EwoudVV/rgb-tiles/images/tile-layout-sketch.png

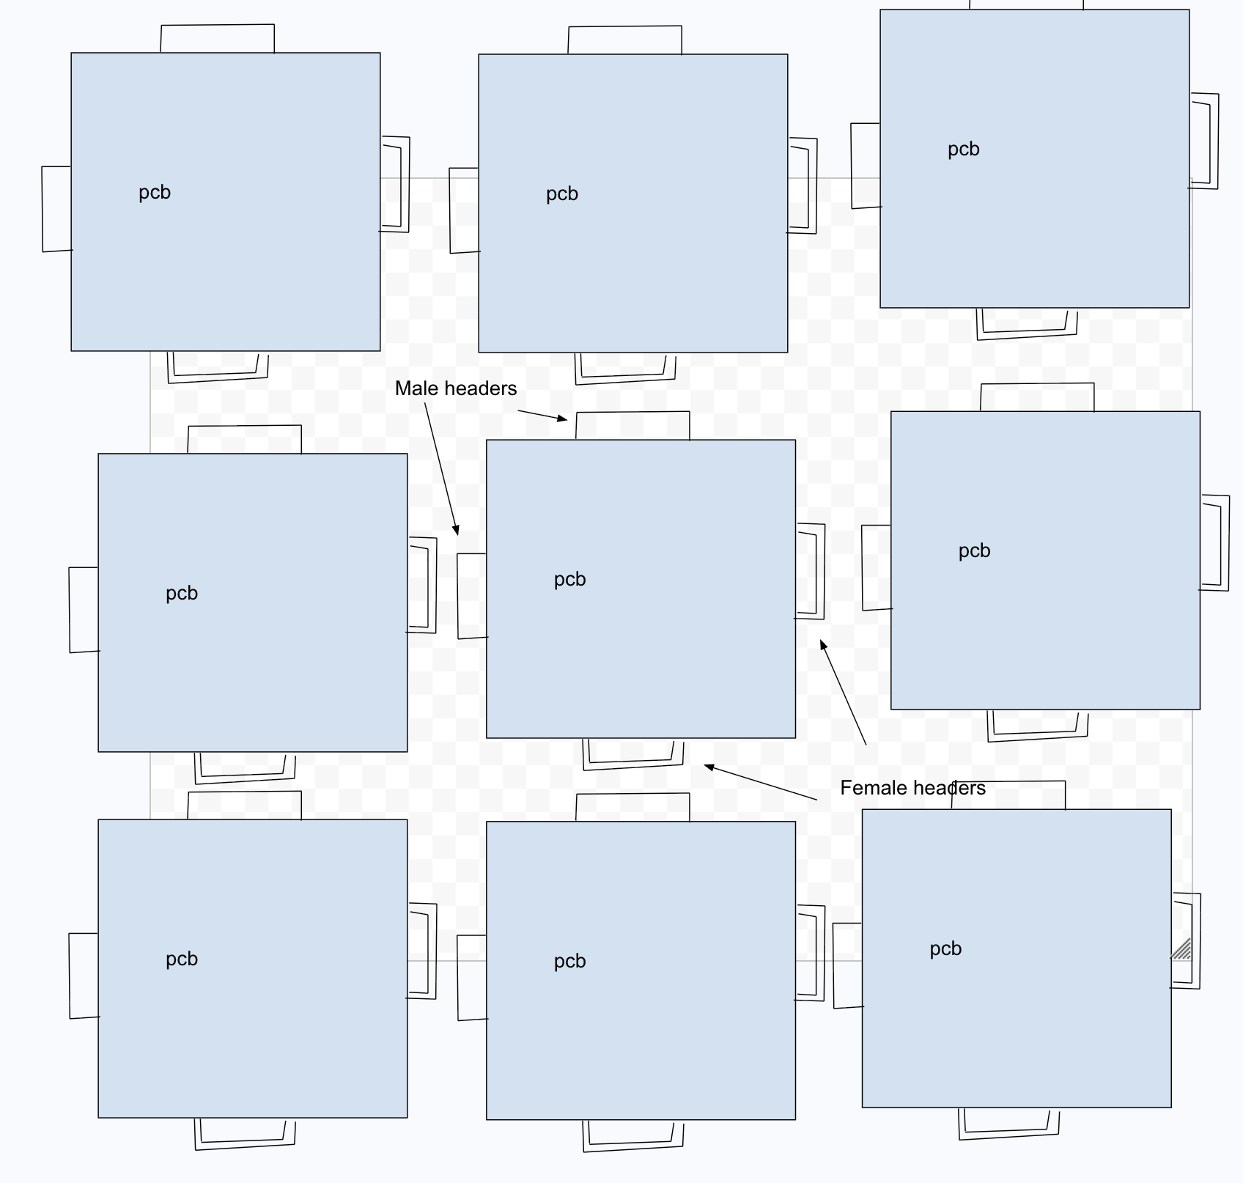
images/tile-layout-sketch.png
