EwoudVV/rgb-tiles/images/tile-render.png

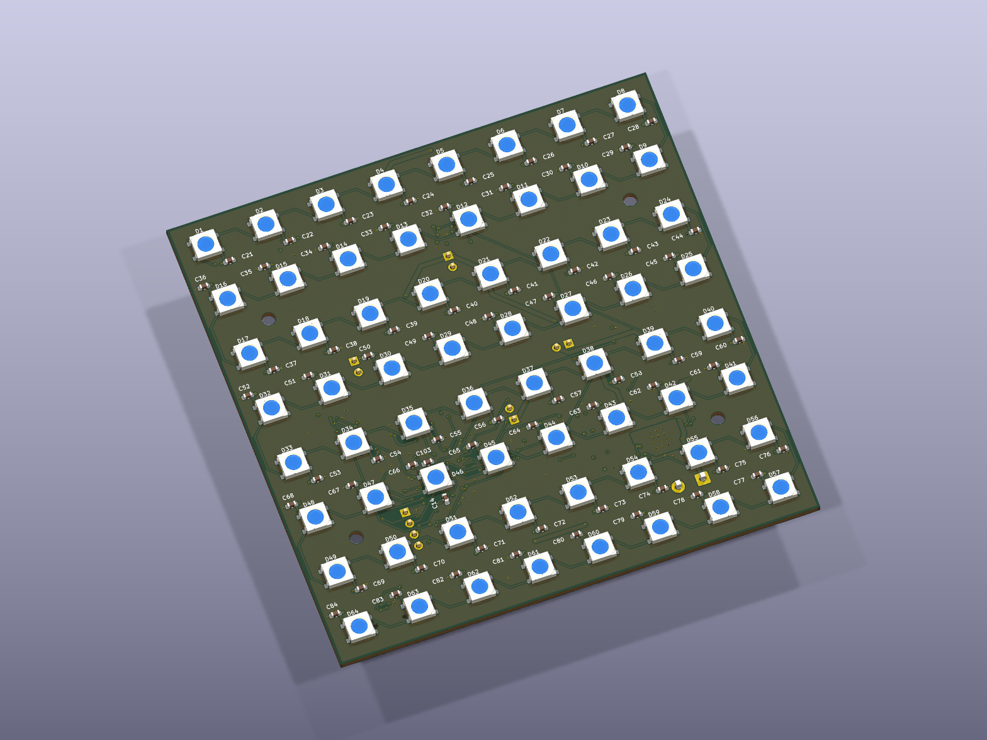
images/tile-render.png
