EwoudVV/rgb-tiles/rgb-tiles.kicad_pcb

## KiCad design rgb-tiles.kicad_pcb (2026-10-29)

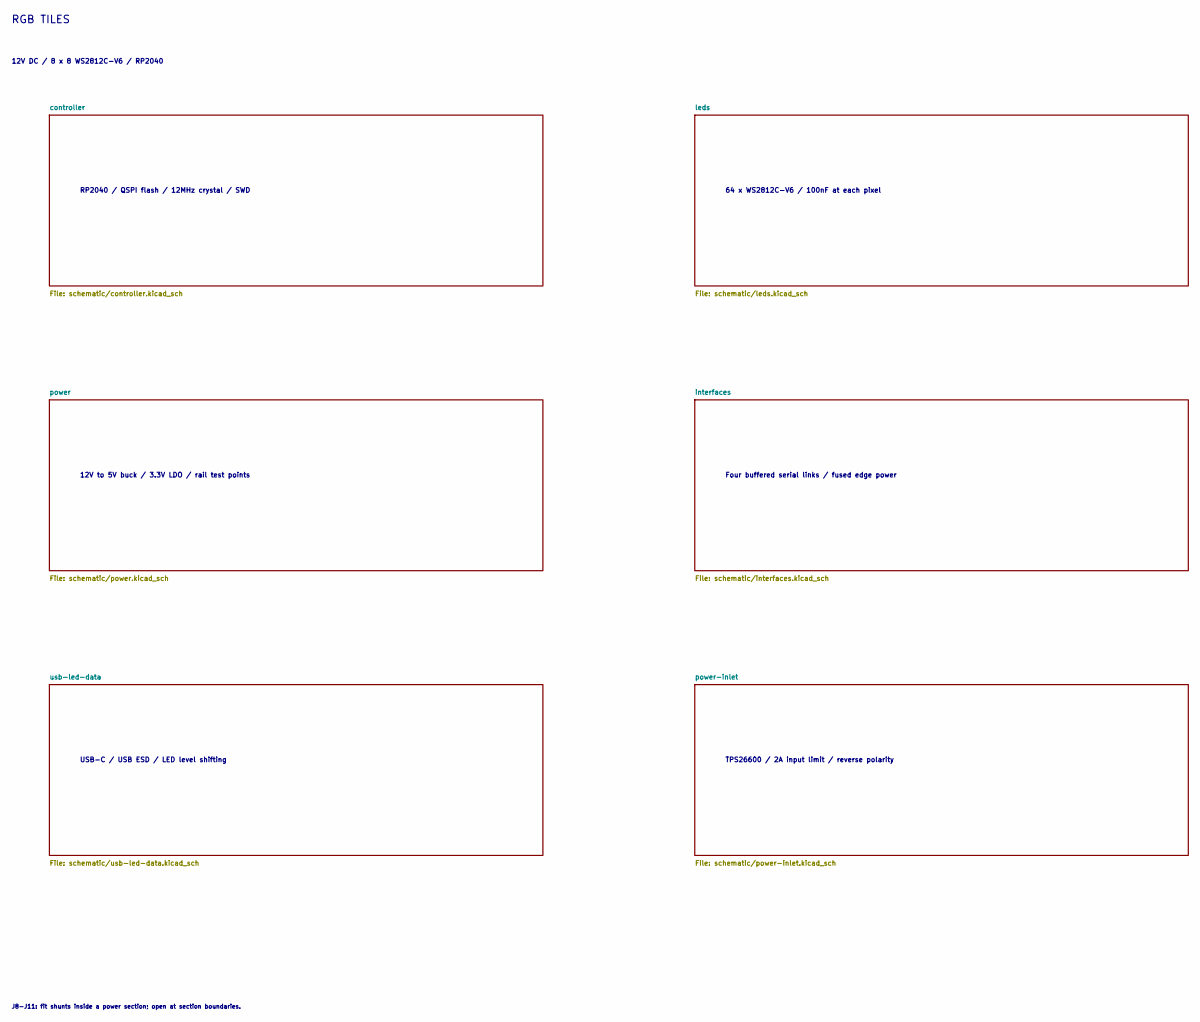
[picture p5: schematic rgb-tiles.kicad_sch, RGB Tiles]

Notes on the sheet:
RGB TILES
12V DC / 8 x 8 WS2812C-V6 / RP2040
J8-J11: fit shunts inside a power section; open at section boundaries.
RP2040 / QSPI flash / 12MHz crystal / SWD
64 x WS2812C-V6 / 100nF at each pixel
12V to 5V buck / 3.3V LDO / rail test points
Four buffered serial links / fused edge power
USB-C / USB ESD / LED level shifting
TPS26600 / 2A input limit / reverse polarity

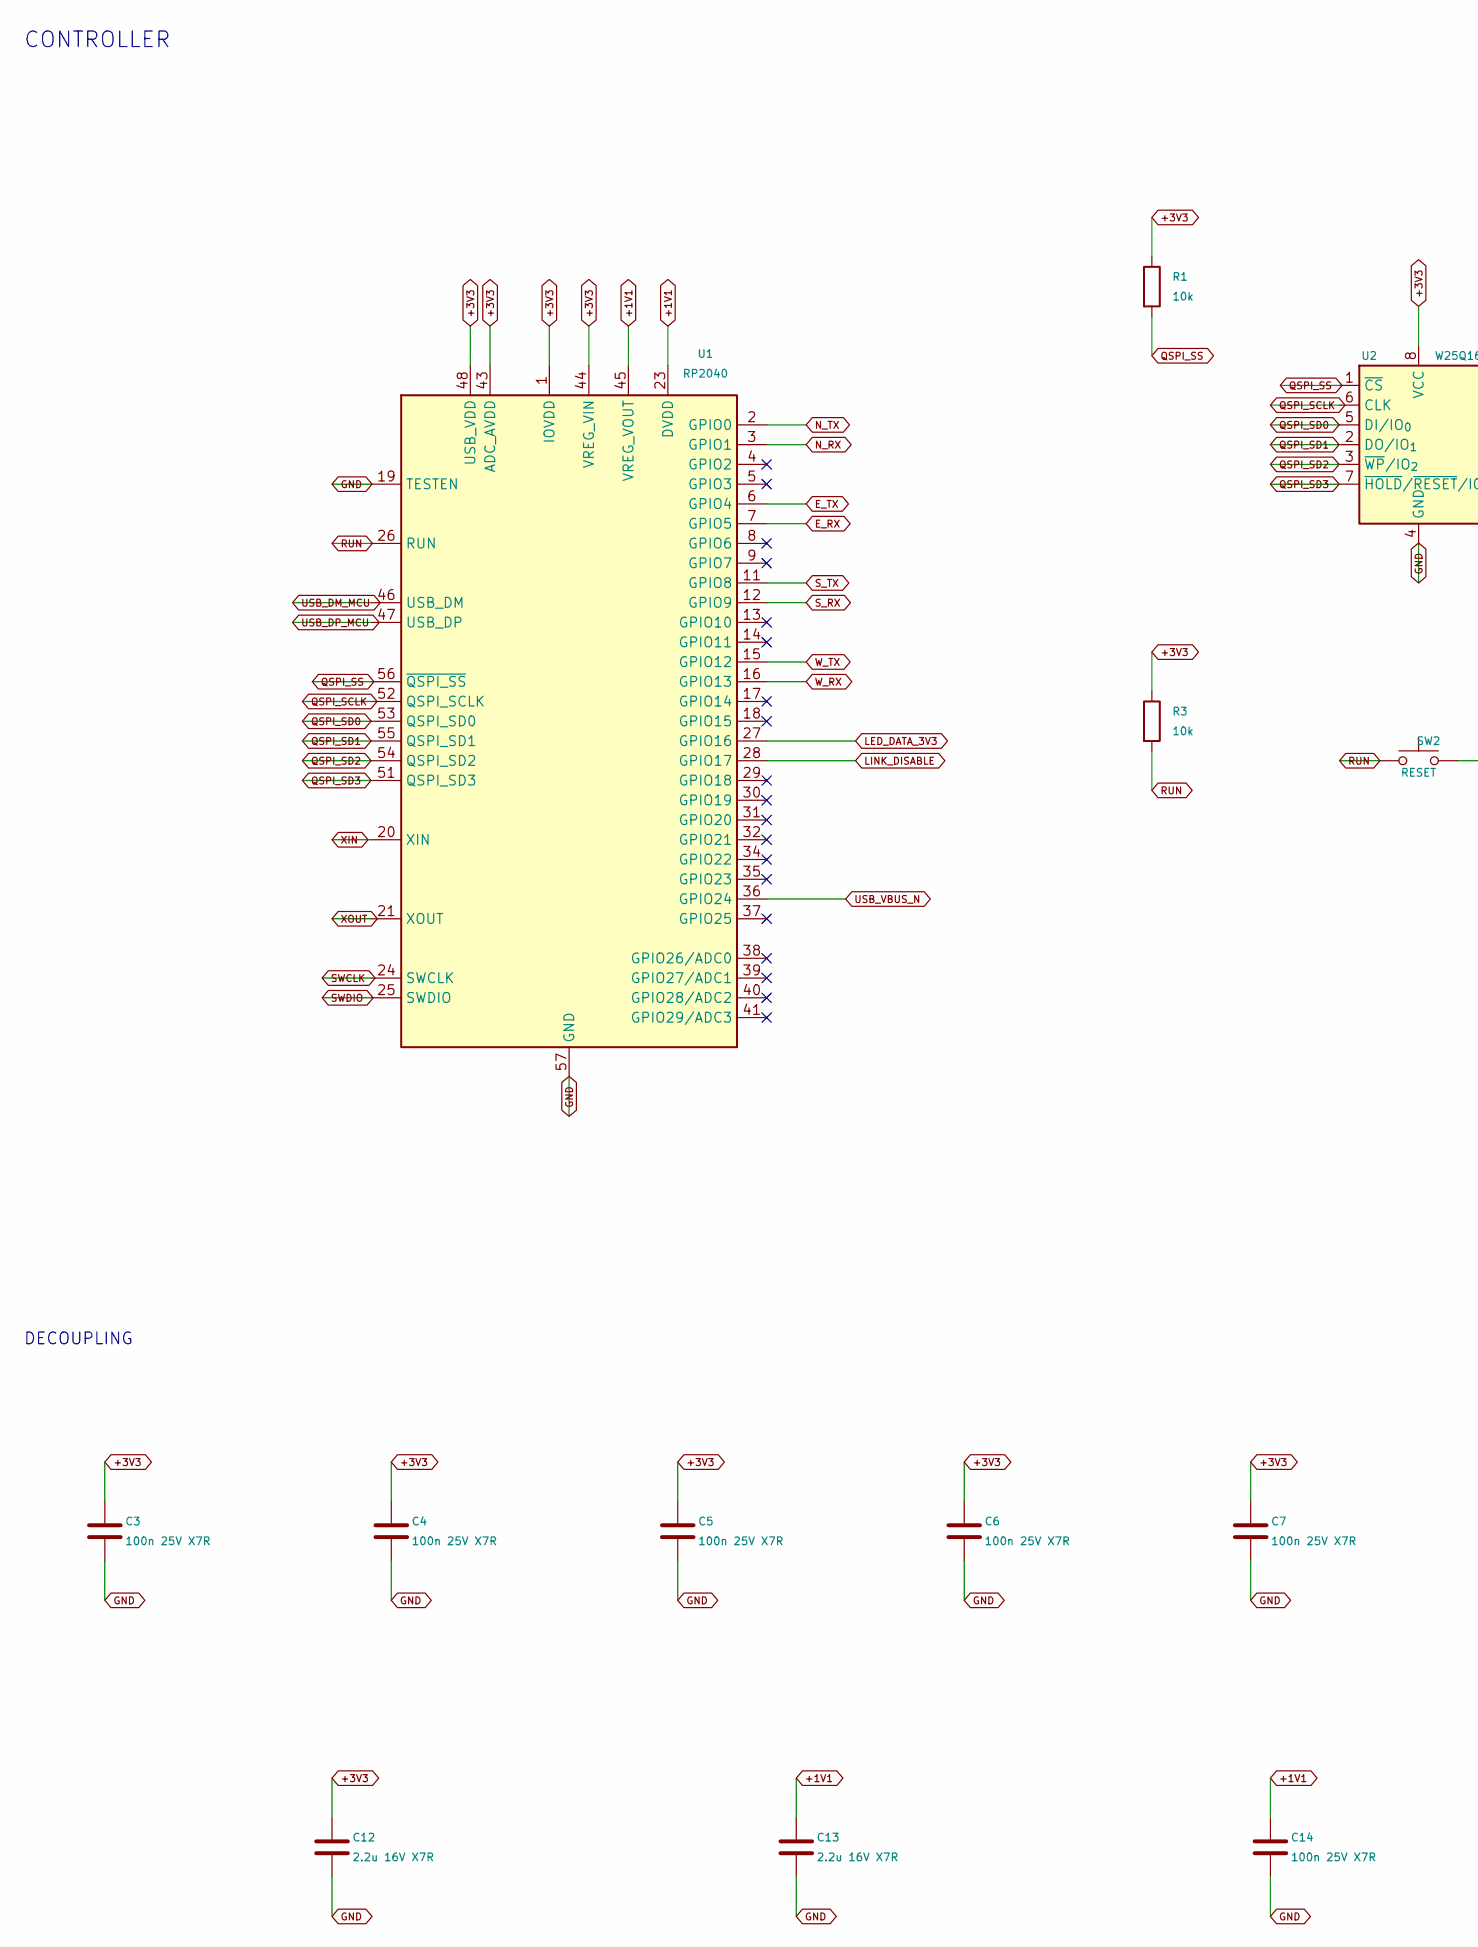
[picture p6: schematic controller.kicad_sch, RGB Tiles, part in row 1, column 1]

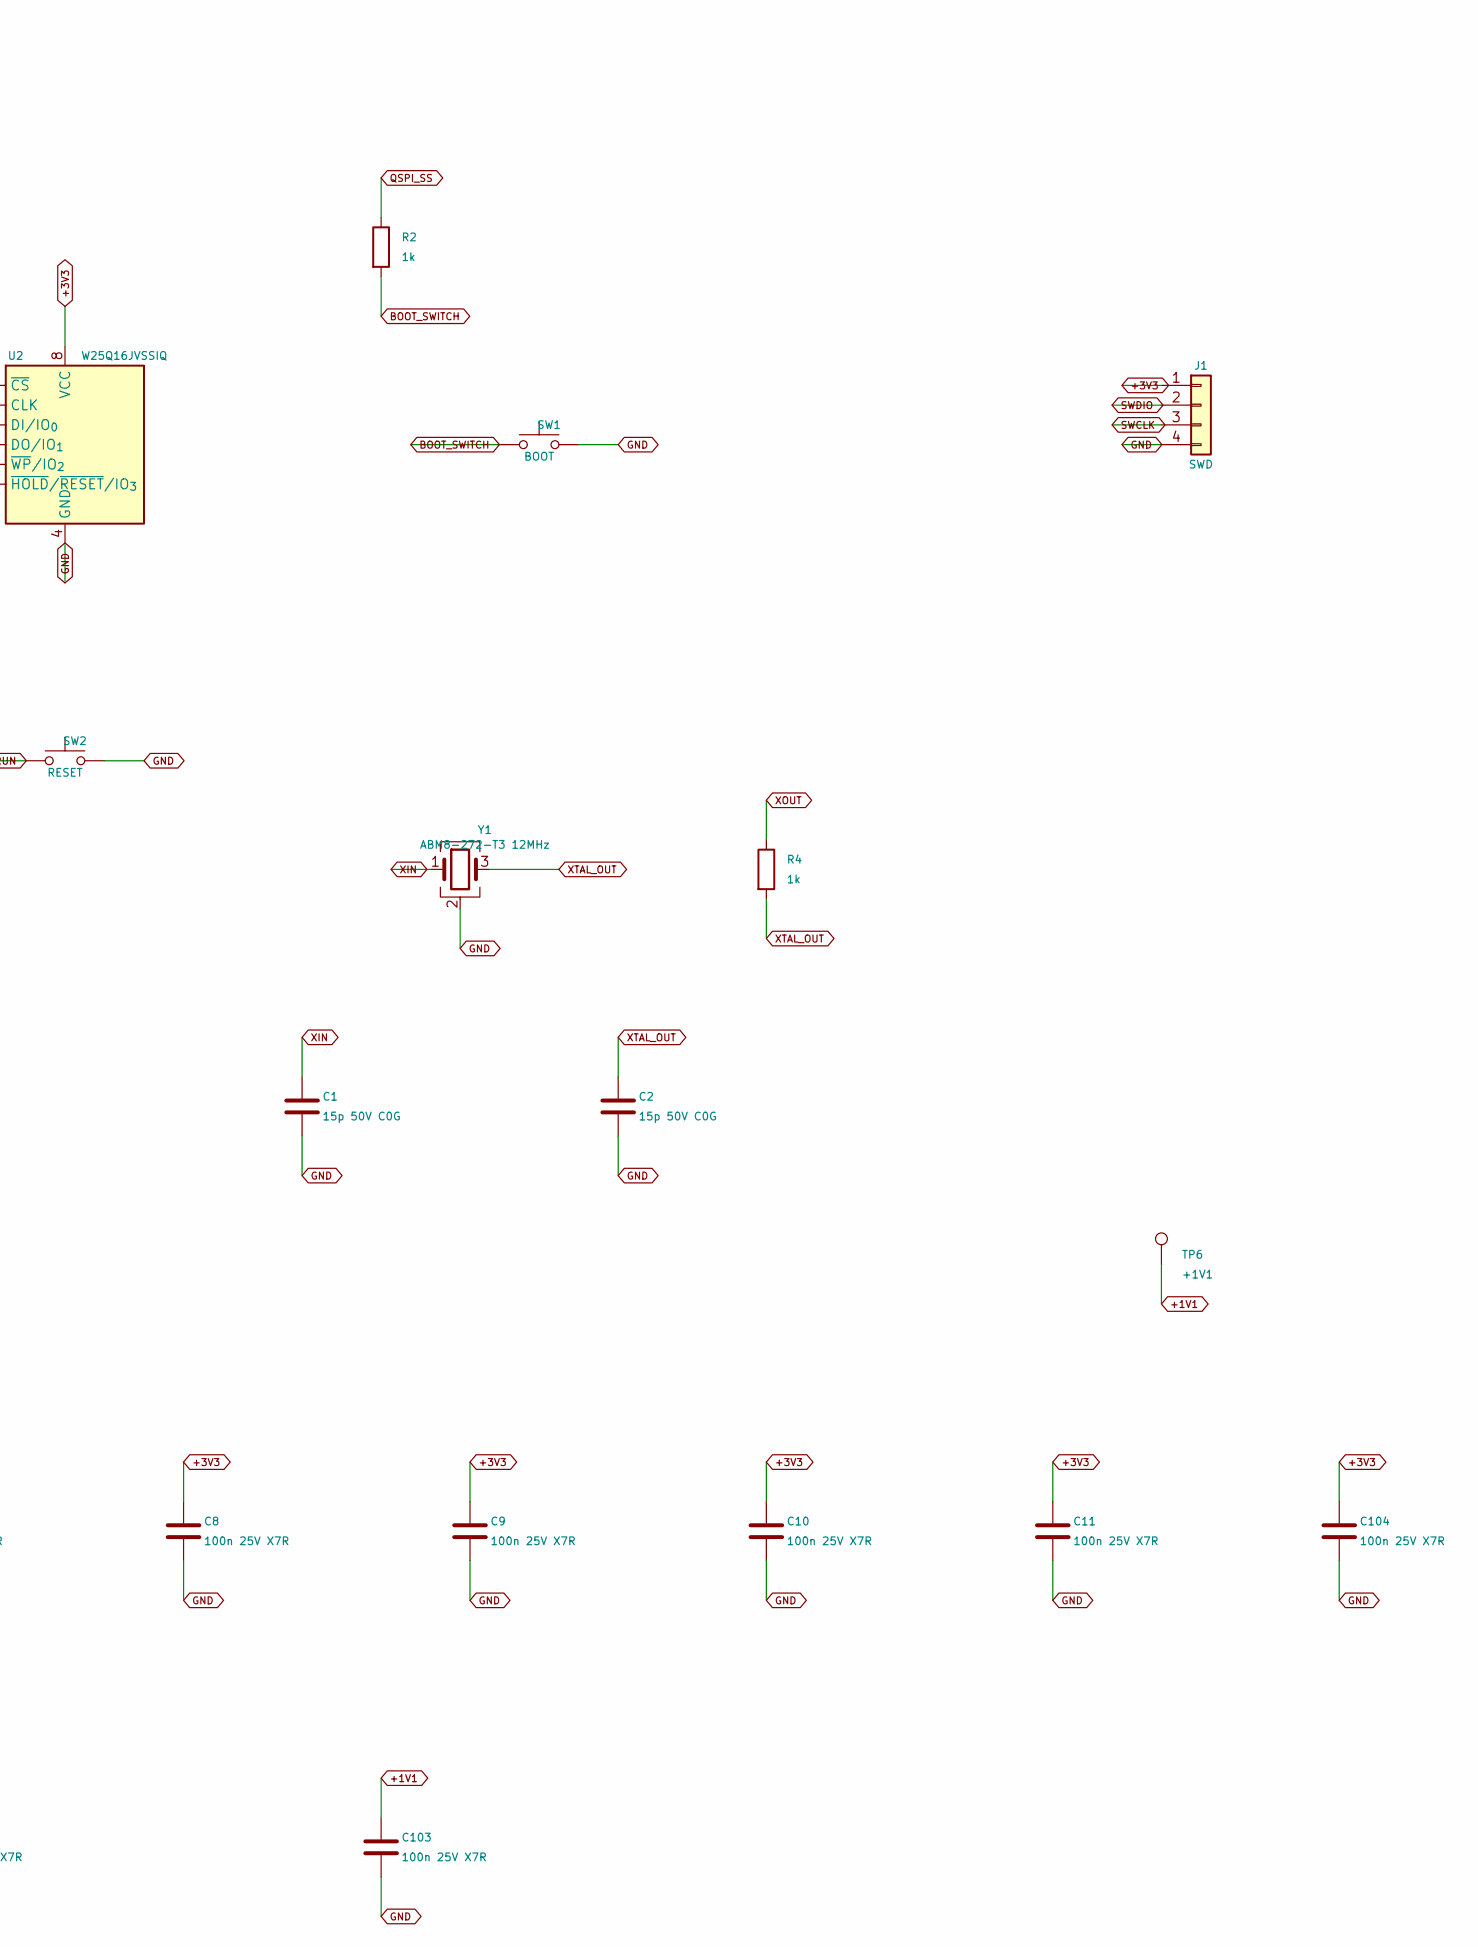
[picture p7: schematic controller.kicad_sch, RGB Tiles, part in row 1, column 2]

Parts:
C1, C2: 15p 50V C0G; C_0603_1608Metric; MPN C0603C150J5GACTU
C3, C4, C5, C6, C7, C8, C9, C10, C11, C14, C103, C104: 100n 25V X7R; C_0603_1608Metric; MPN CL10B104KA8NNNC
C12, C13: 2.2u 16V X7R; C_0805_2012Metric; MPN C0805C225K4RACTU
J1: SWD; PinHeader_1x04_P2.54mm_Vertical; MPN TSW-104-07-T-S
R1, R3: 10k; R_0603_1608Metric; Tolerance 1%; MPN RC0603FR-0710KL
R2, R4: 1k; R_0603_1608Metric; Tolerance 1%; MPN RC0603FR-071KL
SW1: BOOT; SW_SPST_TL3342; MPN TL3342F160QG
SW2: RESET; SW_SPST_TL3342; MPN TL3342F160QG
TP6: +1V1; TestPoint_Pad_D1.5mm
U1: RP2040; QFN-56-1EP_7x7mm_P0.4mm_EP3.2x3.2mm; MPN RP2040
U2: W25Q16JVSSIQ; SOIC-8_5.3x5.3mm_P1.27mm; MPN W25Q16JVSSIM
Y1: ABM8-272-T3 12MHz; Crystal_SMD_3225-4Pin_3.2x2.5mm; MPN ABM8-272-T3

Connections:
+1V1: C13.1, C14.1, C103.1, TP6.1, U1.23 (DVDD), U1.45 (VREG_VOUT), U1.50 (DVDD)
+3V3: C3.1, C4.1, C5.1, C6.1, C7.1, C8.1, C9.1, C10.1, C11.1, C12.1, C104.1, J1.1, R1.1, R3.1, U1.1 (IOVDD), U1.10 (IOVDD), U1.22 (IOVDD), U1.33 (IOVDD), U1.42 (IOVDD), U1.43 (ADC_AVDD), U1.44 (VREG_VIN), U1.48 (USB_VDD), U1.49 (IOVDD), U2.8 (VCC); also elsewhere on the board
BOOT_SWITCH: R2.2, SW1.1
E_RX: U1.7 (GPIO5); also elsewhere on the board
E_TX: U1.6 (GPIO4); also elsewhere on the board
GND: C1.2, C2.2, C3.2, C4.2, C5.2, C6.2, C7.2, C8.2, C9.2, C10.2, C11.2, C12.2, C13.2, C14.2, C103.2, C104.2, J1.4, SW1.2, SW2.2, U1.19 (TESTEN), U1.57 (GND), U2.4 (GND), Y1.2 (G), Y1.4 (G); also elsewhere on the board
LED_DATA_3V3: U1.27 (GPIO16); also elsewhere on the board
LINK_DISABLE: U1.28 (GPIO17); also elsewhere on the board
N_RX: U1.3 (GPIO1); also elsewhere on the board
N_TX: U1.2 (GPIO0); also elsewhere on the board
QSPI_SCLK: U1.52 (QSPI_SCLK), U2.6 (CLK)
QSPI_SD0: U1.53 (QSPI_SD0), U2.5 (DI/IO_{0})
QSPI_SD1: U1.55 (QSPI_SD1), U2.2 (DO/IO_{1})
QSPI_SD2: U1.54 (QSPI_SD2), U2.3 (~WP/IO_{2})
QSPI_SD3: U1.51 (QSPI_SD3), U2.7 (~HOLD/~RESET/IO_{3})
QSPI_SS: R1.2, R2.1, U1.56 (~QSPI_SS), U2.1 (~CS)
RUN: R3.2, SW2.1, U1.26 (RUN)
SWCLK: J1.3, U1.24 (SWCLK)
SWDIO: J1.2, U1.25 (SWDIO)
S_RX: U1.12 (GPIO9); also elsewhere on the board
S_TX: U1.11 (GPIO8); also elsewhere on the board
USB_DM_MCU: U1.46 (USB_DM); also elsewhere on the board
USB_DP_MCU: U1.47 (USB_DP); also elsewhere on the board
USB_VBUS_N: U1.36 (GPIO24); also elsewhere on the board
W_RX: U1.16 (GPIO13); also elsewhere on the board
W_TX: U1.15 (GPIO12); also elsewhere on the board
XIN: C1.1, U1.20 (XIN), Y1.1
XOUT: R4.1, U1.21 (XOUT)
XTAL_OUT: C2.1, R4.2, Y1.3

Notes on the sheet:
CONTROLLER
DECOUPLING
