EwoudVV/rgb-tiles/rgb-tiles.kicad_pcb

## KiCad design rgb-tiles.kicad_pcb (continued)

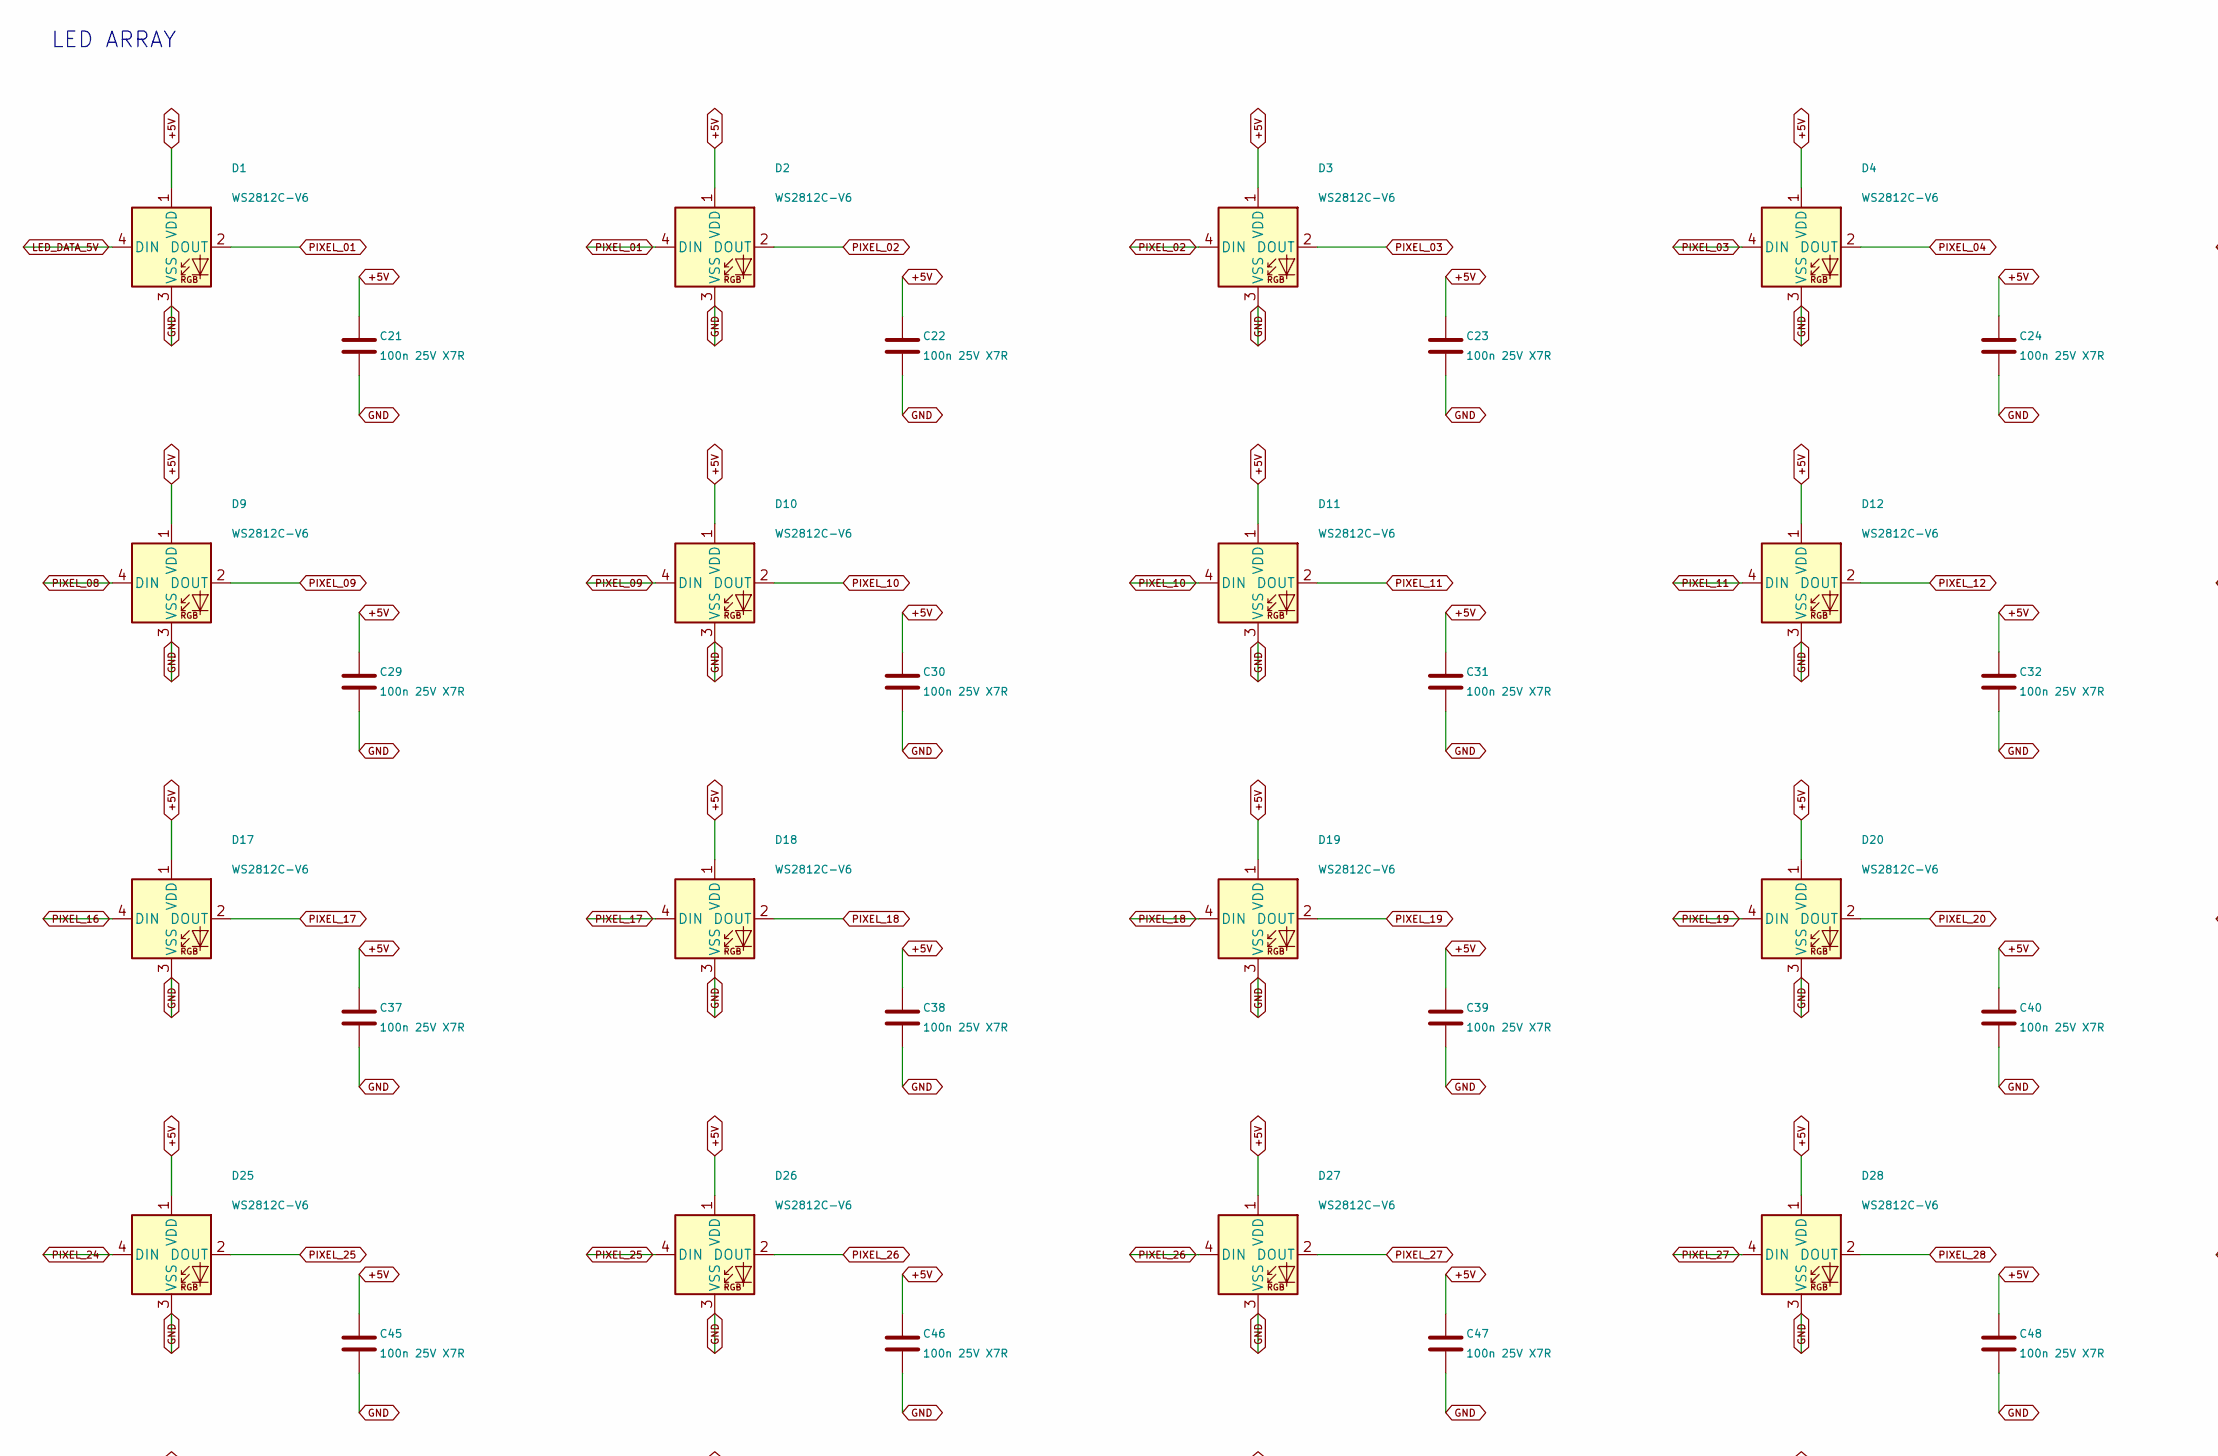
[picture p8: schematic leds.kicad_sch, RGB Tiles, part in row 1, column 1]

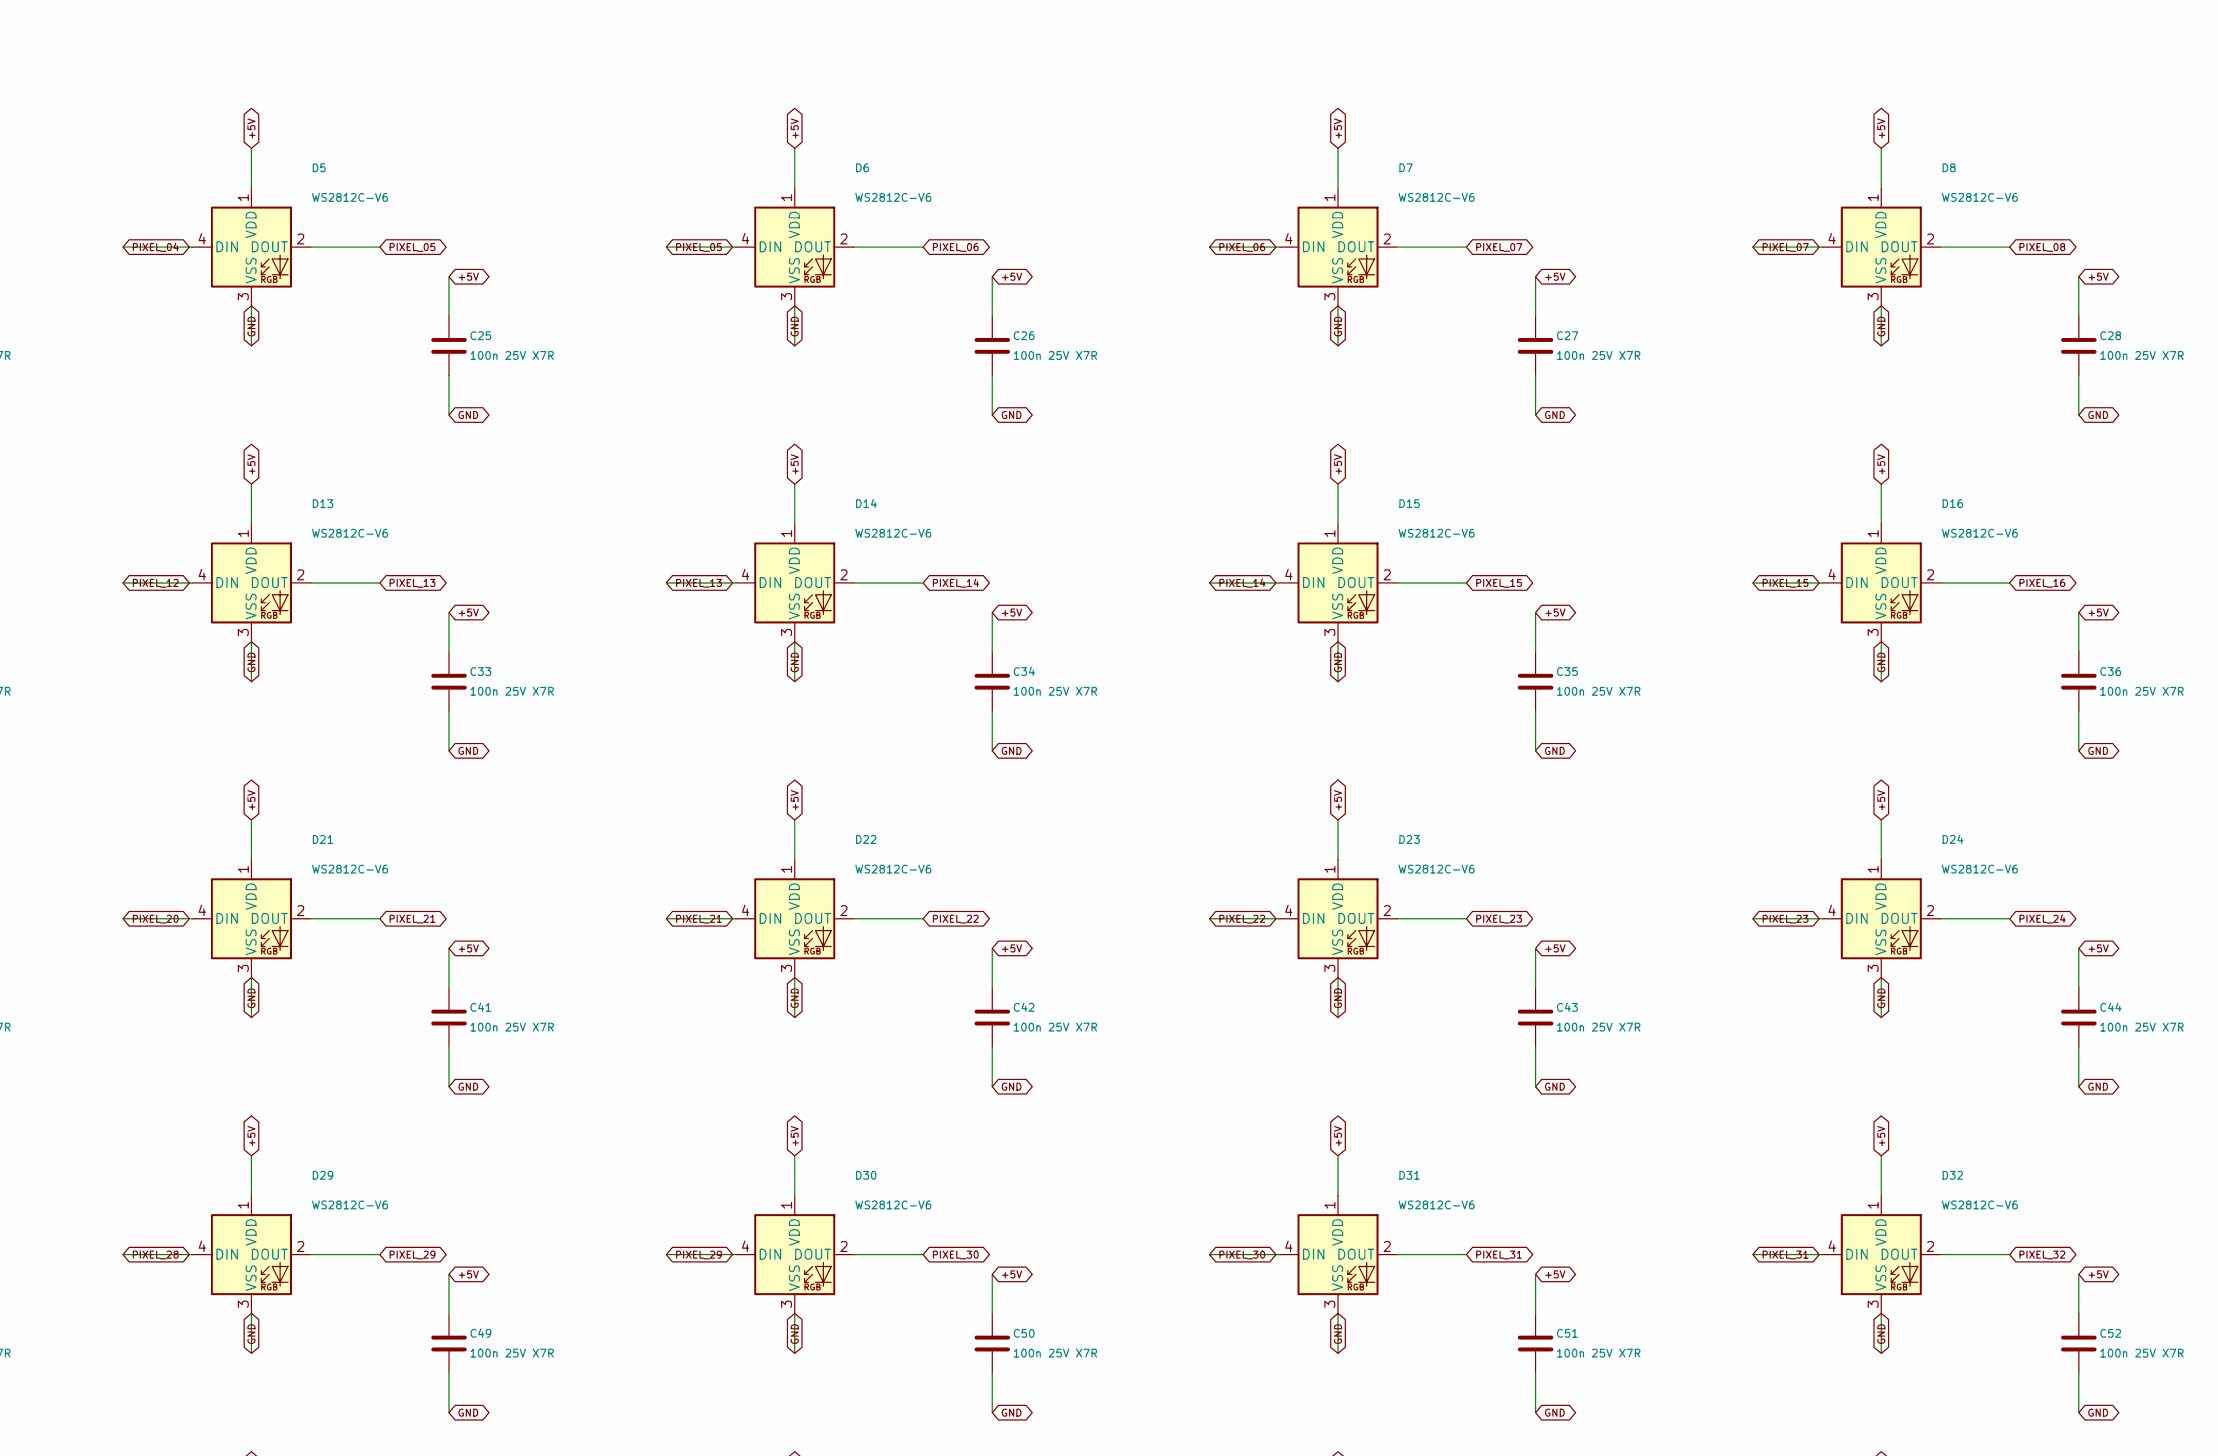
[picture p9: schematic leds.kicad_sch, RGB Tiles, part in row 1, column 2]

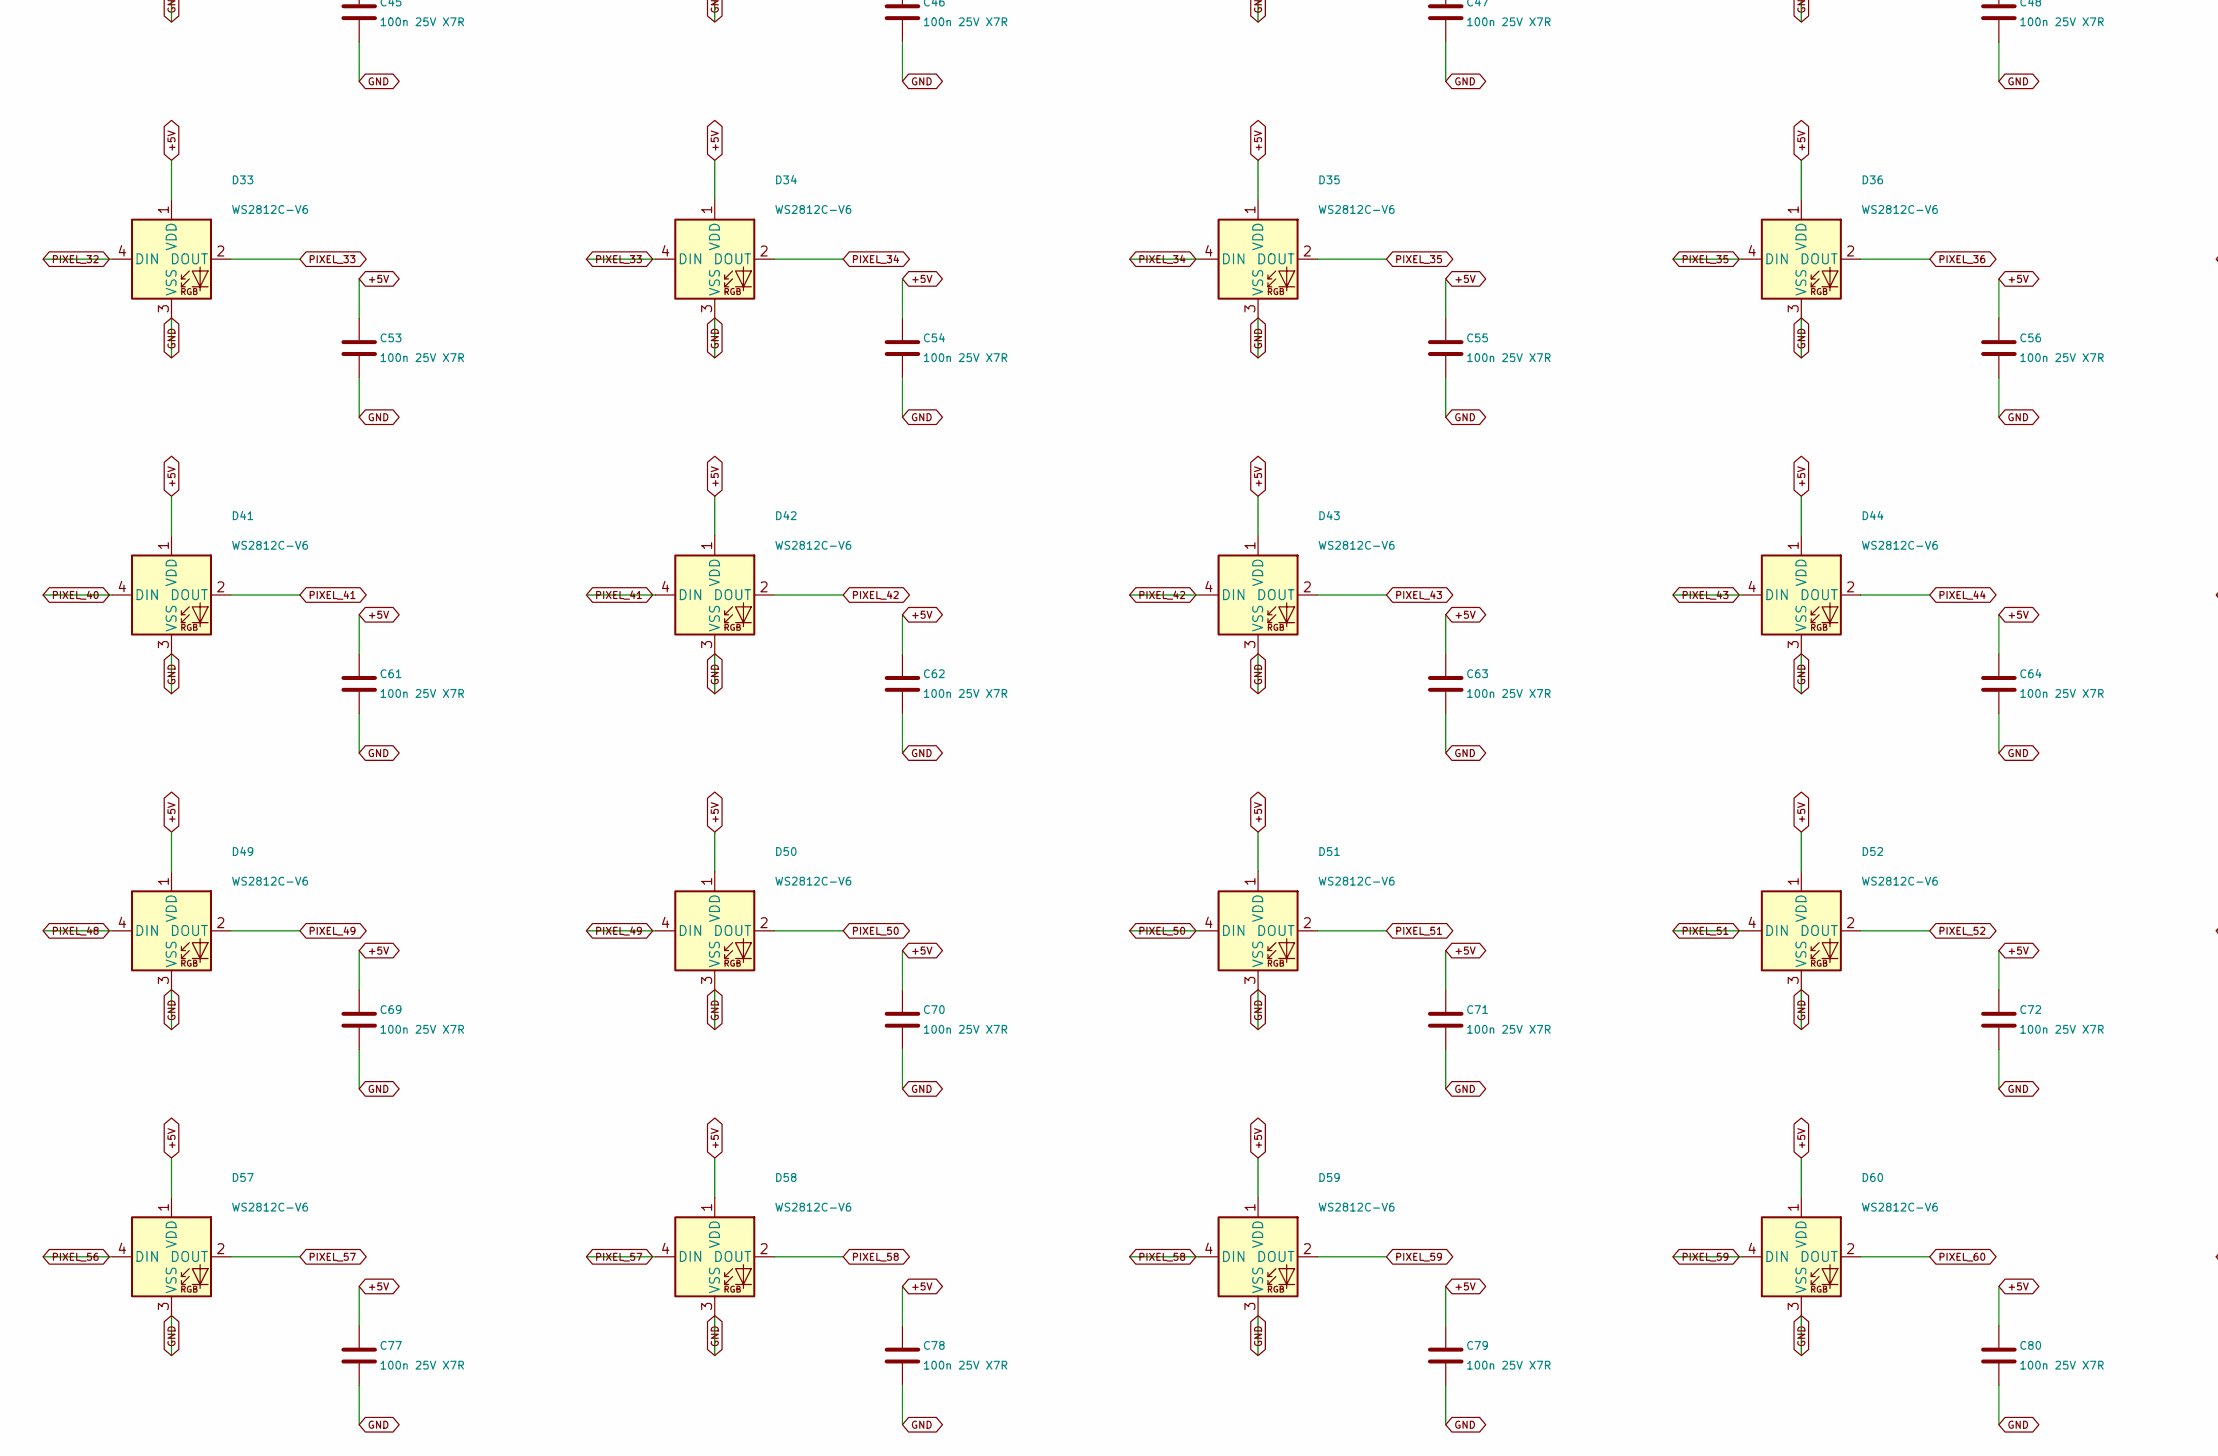
[picture p10: schematic leds.kicad_sch, RGB Tiles, part in row 2, column 1]

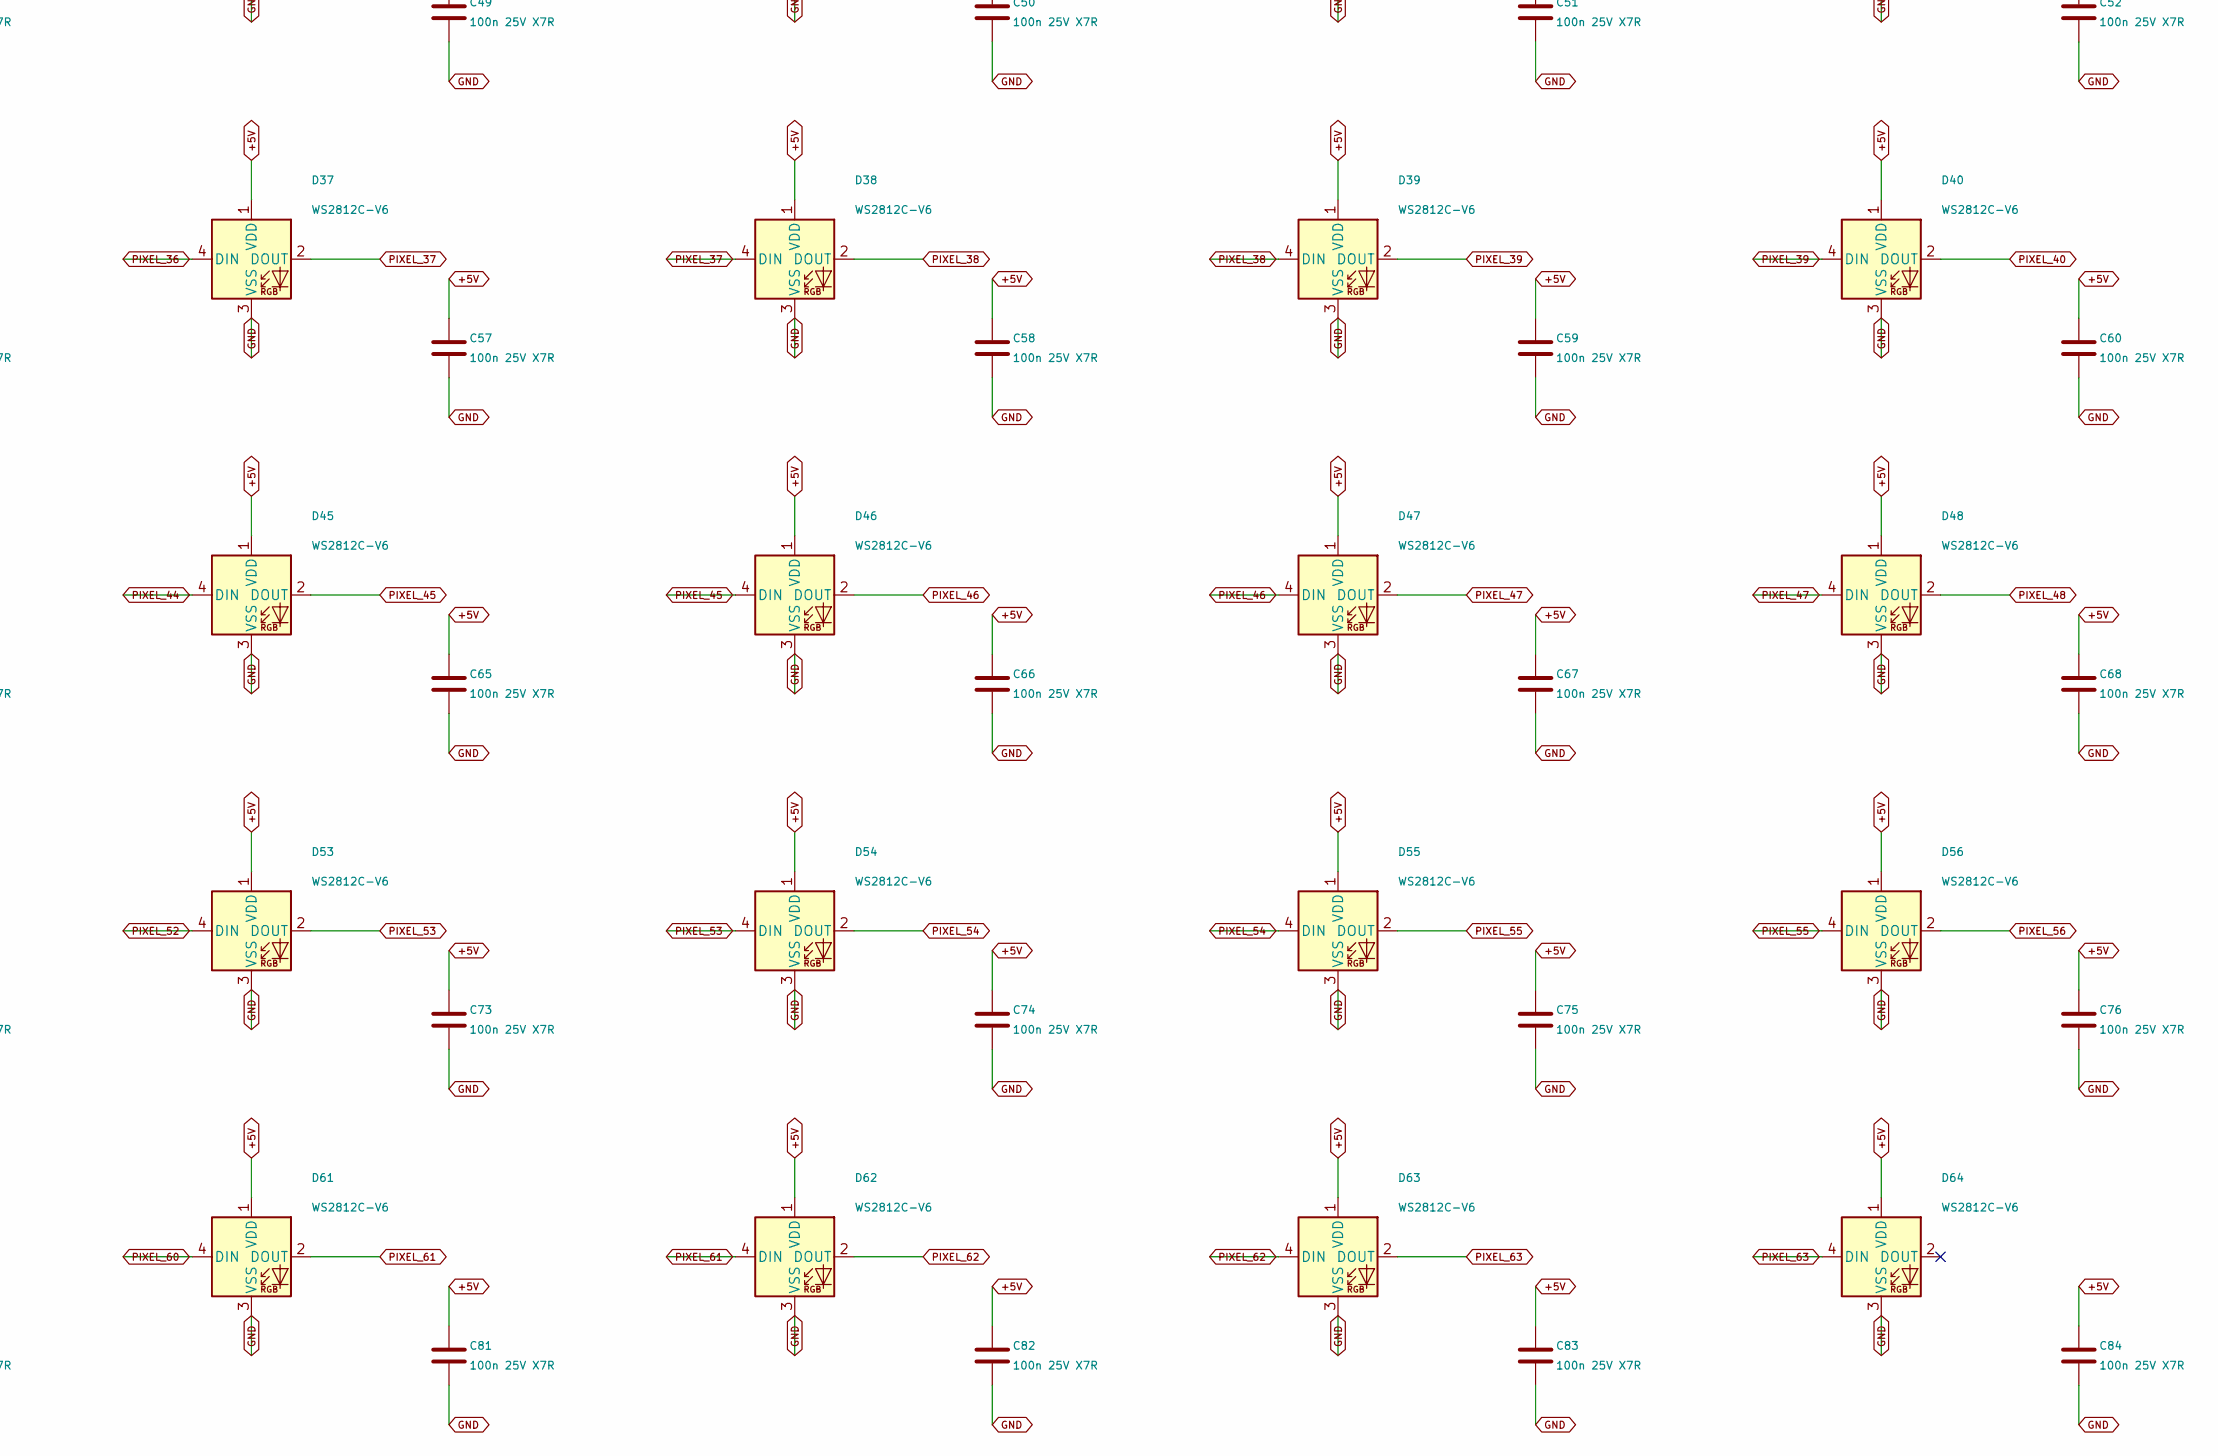
[picture p11: schematic leds.kicad_sch, RGB Tiles, part in row 2, column 2]

Parts:
C21, C22, C23, C24, C25, C26, C27, C28, C29, C30, C31, C32, C33, C34, C35, C36, C37, C38, C39, C40, C41, C42, C43, C44, C45, C46, C47, C48, C49, C50, C51, C52, C53, C54, C55, C56, C57, C58, C59, C60, C61, C62, C63, C64, C65, C66, C67, C68, C69, C70, C71, C72, C73, C74, C75, C76, C77, C78, C79, C80, C81, C82, C83, C84: 100n 25V X7R; C_0603_1608Metric; MPN CL10B104KA8NNNC
D1, D2, D3, D4, D5, D6, D7, D8, D9, D10, D11, D12, D13, D14, D15, D16, D17, D18, D19, D20, D21, D22, D23, D24, D25, D26, D27, D28, D29, D30, D31, D32, D33, D34, D35, D36, D37, D38, D39, D40, D41, D42, D43, D44, D45, D46, D47, D48, D49, D50, D51, D52, D53, D54, D55, D56, D57, D58, D59, D60, D61, D62, D63, D64: WS2812C-V6; LED_WS2812C-V6_5050_SteppedCourtyard; MPN WS2812C-V6

Connections:
+5V: C21.1, C22.1, C23.1, C24.1, C25.1, C26.1, C27.1, C28.1, C29.1, C30.1, C31.1, C32.1, C33.1, C34.1, C35.1, C36.1, C37.1, C38.1, C39.1, C40.1, C41.1, C42.1, C43.1, C44.1, C45.1, C46.1, C47.1, C48.1, C49.1, C50.1, C51.1, C52.1, C53.1, C54.1, C55.1, C56.1, C57.1, C58.1, C59.1, C60.1, C61.1, C62.1, C63.1, C64.1, C65.1, C66.1, C67.1, C68.1, C69.1, C70.1, C71.1, C72.1, C73.1, C74.1, C75.1, C76.1, C77.1, C78.1, C79.1, C80.1, C81.1, C82.1, C83.1, C84.1, D1.1 (VDD), D2.1 (VDD), D3.1 (VDD), D4.1 (VDD), D5.1 (VDD), D6.1 (VDD), D7.1 (VDD), D8.1 (VDD), D9.1 (VDD), D10.1 (VDD), D11.1 (VDD), D12.1 (VDD), D13.1 (VDD), D14.1 (VDD), D15.1 (VDD), D16.1 (VDD), D17.1 (VDD), D18.1 (VDD), D19.1 (VDD), D20.1 (VDD), D21.1 (VDD), D22.1 (VDD), D23.1 (VDD), D24.1 (VDD), D25.1 (VDD), D26.1 (VDD), D27.1 (VDD), D28.1 (VDD), D29.1 (VDD), D30.1 (VDD), D31.1 (VDD), D32.1 (VDD), D33.1 (VDD), D34.1 (VDD), D35.1 (VDD), D36.1 (VDD), D37.1 (VDD), D38.1 (VDD), D39.1 (VDD), D40.1 (VDD), D41.1 (VDD), D42.1 (VDD), D43.1 (VDD), D44.1 (VDD), D45.1 (VDD), D46.1 (VDD), D47.1 (VDD), D48.1 (VDD), D49.1 (VDD), D50.1 (VDD), D51.1 (VDD), D52.1 (VDD), D53.1 (VDD), D54.1 (VDD), D55.1 (VDD), D56.1 (VDD), D57.1 (VDD), D58.1 (VDD), D59.1 (VDD), D60.1 (VDD), D61.1 (VDD), D62.1 (VDD), D63.1 (VDD), D64.1 (VDD); also elsewhere on the board
GND: C21.2, C22.2, C23.2, C24.2, C25.2, C26.2, C27.2, C28.2, C29.2, C30.2, C31.2, C32.2, C33.2, C34.2, C35.2, C36.2, C37.2, C38.2, C39.2, C40.2, C41.2, C42.2, C43.2, C44.2, C45.2, C46.2, C47.2, C48.2, C49.2, C50.2, C51.2, C52.2, C53.2, C54.2, C55.2, C56.2, C57.2, C58.2, C59.2, C60.2, C61.2, C62.2, C63.2, C64.2, C65.2, C66.2, C67.2, C68.2, C69.2, C70.2, C71.2, C72.2, C73.2, C74.2, C75.2, C76.2, C77.2, C78.2, C79.2, C80.2, C81.2, C82.2, C83.2, C84.2, D1.3 (VSS), D2.3 (VSS), D3.3 (VSS), D4.3 (VSS), D5.3 (VSS), D6.3 (VSS), D7.3 (VSS), D8.3 (VSS), D9.3 (VSS), D10.3 (VSS), D11.3 (VSS), D12.3 (VSS), D13.3 (VSS), D14.3 (VSS), D15.3 (VSS), D16.3 (VSS), D17.3 (VSS), D18.3 (VSS), D19.3 (VSS), D20.3 (VSS), D21.3 (VSS), D22.3 (VSS), D23.3 (VSS), D24.3 (VSS), D25.3 (VSS), D26.3 (VSS), D27.3 (VSS), D28.3 (VSS), D29.3 (VSS), D30.3 (VSS), D31.3 (VSS), D32.3 (VSS), D33.3 (VSS), D34.3 (VSS), D35.3 (VSS), D36.3 (VSS), D37.3 (VSS), D38.3 (VSS), D39.3 (VSS), D40.3 (VSS), D41.3 (VSS), D42.3 (VSS), D43.3 (VSS), D44.3 (VSS), D45.3 (VSS), D46.3 (VSS), D47.3 (VSS), D48.3 (VSS), D49.3 (VSS), D50.3 (VSS), D51.3 (VSS), D52.3 (VSS), D53.3 (VSS), D54.3 (VSS), D55.3 (VSS), D56.3 (VSS), D57.3 (VSS), D58.3 (VSS), D59.3 (VSS), D60.3 (VSS), D61.3 (VSS), D62.3 (VSS), D63.3 (VSS), D64.3 (VSS); also elsewhere on the board
LED_DATA_5V: D1.4 (DIN); also elsewhere on the board
PIXEL_01: D1.2 (DOUT), D2.4 (DIN)
PIXEL_02: D2.2 (DOUT), D3.4 (DIN)
PIXEL_03: D3.2 (DOUT), D4.4 (DIN)
PIXEL_04: D4.2 (DOUT), D5.4 (DIN)
PIXEL_05: D5.2 (DOUT), D6.4 (DIN)
PIXEL_06: D6.2 (DOUT), D7.4 (DIN)
PIXEL_07: D7.2 (DOUT), D8.4 (DIN)
PIXEL_08: D8.2 (DOUT), D9.4 (DIN)
PIXEL_09: D9.2 (DOUT), D10.4 (DIN)
PIXEL_10: D10.2 (DOUT), D11.4 (DIN)
PIXEL_11: D11.2 (DOUT), D12.4 (DIN)
PIXEL_12: D12.2 (DOUT), D13.4 (DIN)
PIXEL_13: D13.2 (DOUT), D14.4 (DIN)
PIXEL_14: D14.2 (DOUT), D15.4 (DIN)
PIXEL_15: D15.2 (DOUT), D16.4 (DIN)
PIXEL_16: D16.2 (DOUT), D17.4 (DIN)
PIXEL_17: D17.2 (DOUT), D18.4 (DIN)
PIXEL_18: D18.2 (DOUT), D19.4 (DIN)
PIXEL_19: D19.2 (DOUT), D20.4 (DIN)
PIXEL_20: D20.2 (DOUT), D21.4 (DIN)
PIXEL_21: D21.2 (DOUT), D22.4 (DIN)
PIXEL_22: D22.2 (DOUT), D23.4 (DIN)
PIXEL_23: D23.2 (DOUT), D24.4 (DIN)
PIXEL_24: D24.2 (DOUT), D25.4 (DIN)
PIXEL_25: D25.2 (DOUT), D26.4 (DIN)
PIXEL_26: D26.2 (DOUT), D27.4 (DIN)
PIXEL_27: D27.2 (DOUT), D28.4 (DIN)
PIXEL_28: D28.2 (DOUT), D29.4 (DIN)
PIXEL_29: D29.2 (DOUT), D30.4 (DIN)
PIXEL_30: D30.2 (DOUT), D31.4 (DIN)
PIXEL_31: D31.2 (DOUT), D32.4 (DIN)
PIXEL_32: D32.2 (DOUT), D33.4 (DIN)
PIXEL_33: D33.2 (DOUT), D34.4 (DIN)
PIXEL_34: D34.2 (DOUT), D35.4 (DIN)
PIXEL_35: D35.2 (DOUT), D36.4 (DIN)
PIXEL_36: D36.2 (DOUT), D37.4 (DIN)
PIXEL_37: D37.2 (DOUT), D38.4 (DIN)
PIXEL_38: D38.2 (DOUT), D39.4 (DIN)
PIXEL_39: D39.2 (DOUT), D40.4 (DIN)
PIXEL_40: D40.2 (DOUT), D41.4 (DIN)
PIXEL_41: D41.2 (DOUT), D42.4 (DIN)
PIXEL_42: D42.2 (DOUT), D43.4 (DIN)
PIXEL_43: D43.2 (DOUT), D44.4 (DIN)
PIXEL_44: D44.2 (DOUT), D45.4 (DIN)
PIXEL_45: D45.2 (DOUT), D46.4 (DIN)
PIXEL_46: D46.2 (DOUT), D47.4 (DIN)
PIXEL_47: D47.2 (DOUT), D48.4 (DIN)
PIXEL_48: D48.2 (DOUT), D49.4 (DIN)
PIXEL_49: D49.2 (DOUT), D50.4 (DIN)
PIXEL_50: D50.2 (DOUT), D51.4 (DIN)
PIXEL_51: D51.2 (DOUT), D52.4 (DIN)
PIXEL_52: D52.2 (DOUT), D53.4 (DIN)
PIXEL_53: D53.2 (DOUT), D54.4 (DIN)
PIXEL_54: D54.2 (DOUT), D55.4 (DIN)
PIXEL_55: D55.2 (DOUT), D56.4 (DIN)
PIXEL_56: D56.2 (DOUT), D57.4 (DIN)
PIXEL_57: D57.2 (DOUT), D58.4 (DIN)
PIXEL_58: D58.2 (DOUT), D59.4 (DIN)
PIXEL_59: D59.2 (DOUT), D60.4 (DIN)
PIXEL_60: D60.2 (DOUT), D61.4 (DIN)
PIXEL_61: D61.2 (DOUT), D62.4 (DIN)
PIXEL_62: D62.2 (DOUT), D63.4 (DIN)
PIXEL_63: D63.2 (DOUT), D64.4 (DIN)

Notes on the sheet:
LED ARRAY

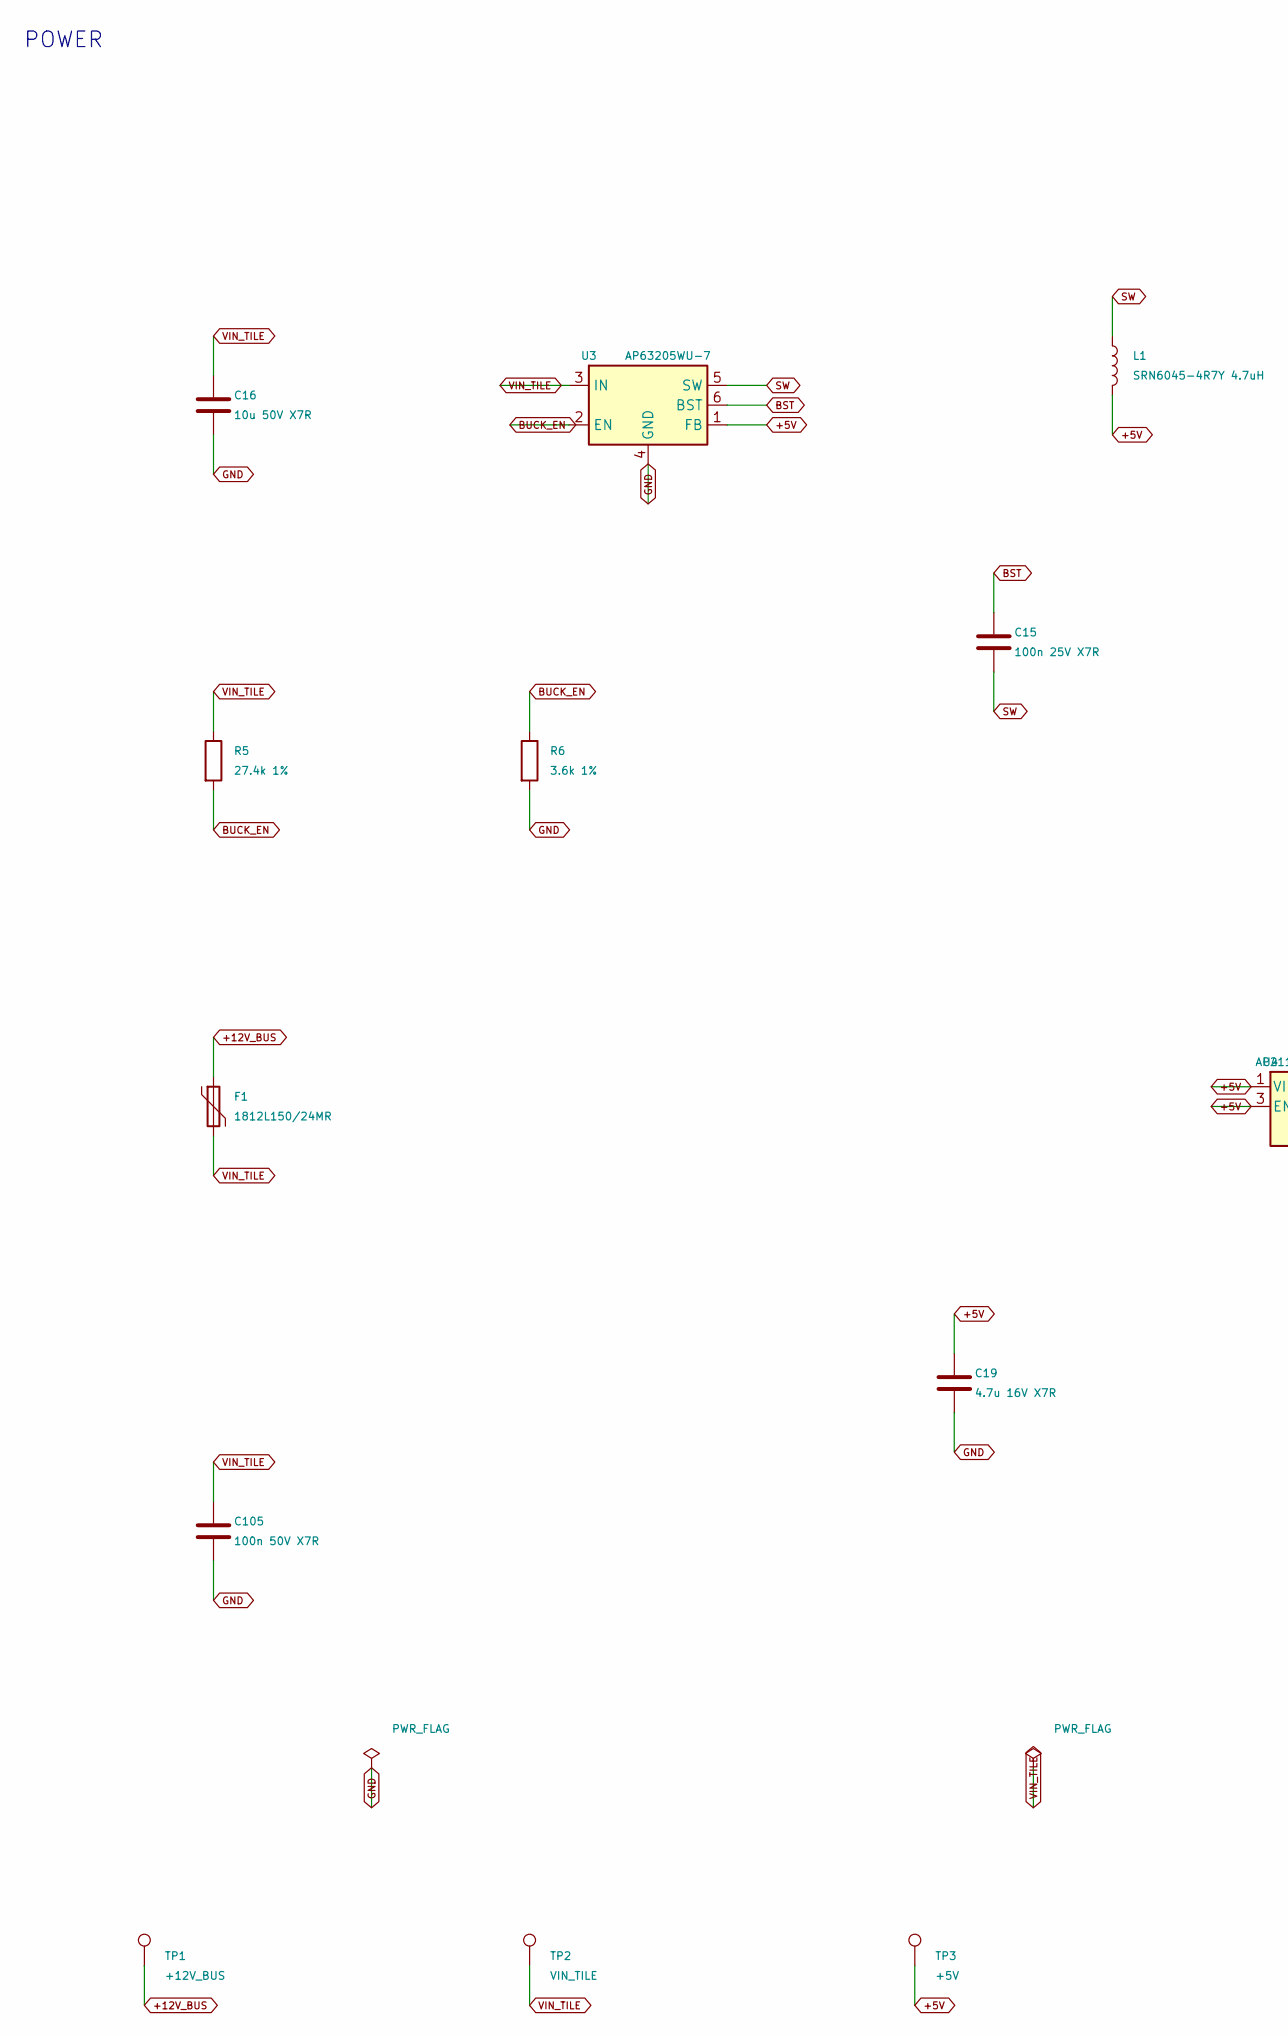
[picture p12: schematic power.kicad_sch, RGB Tiles, part in row 1, column 1]

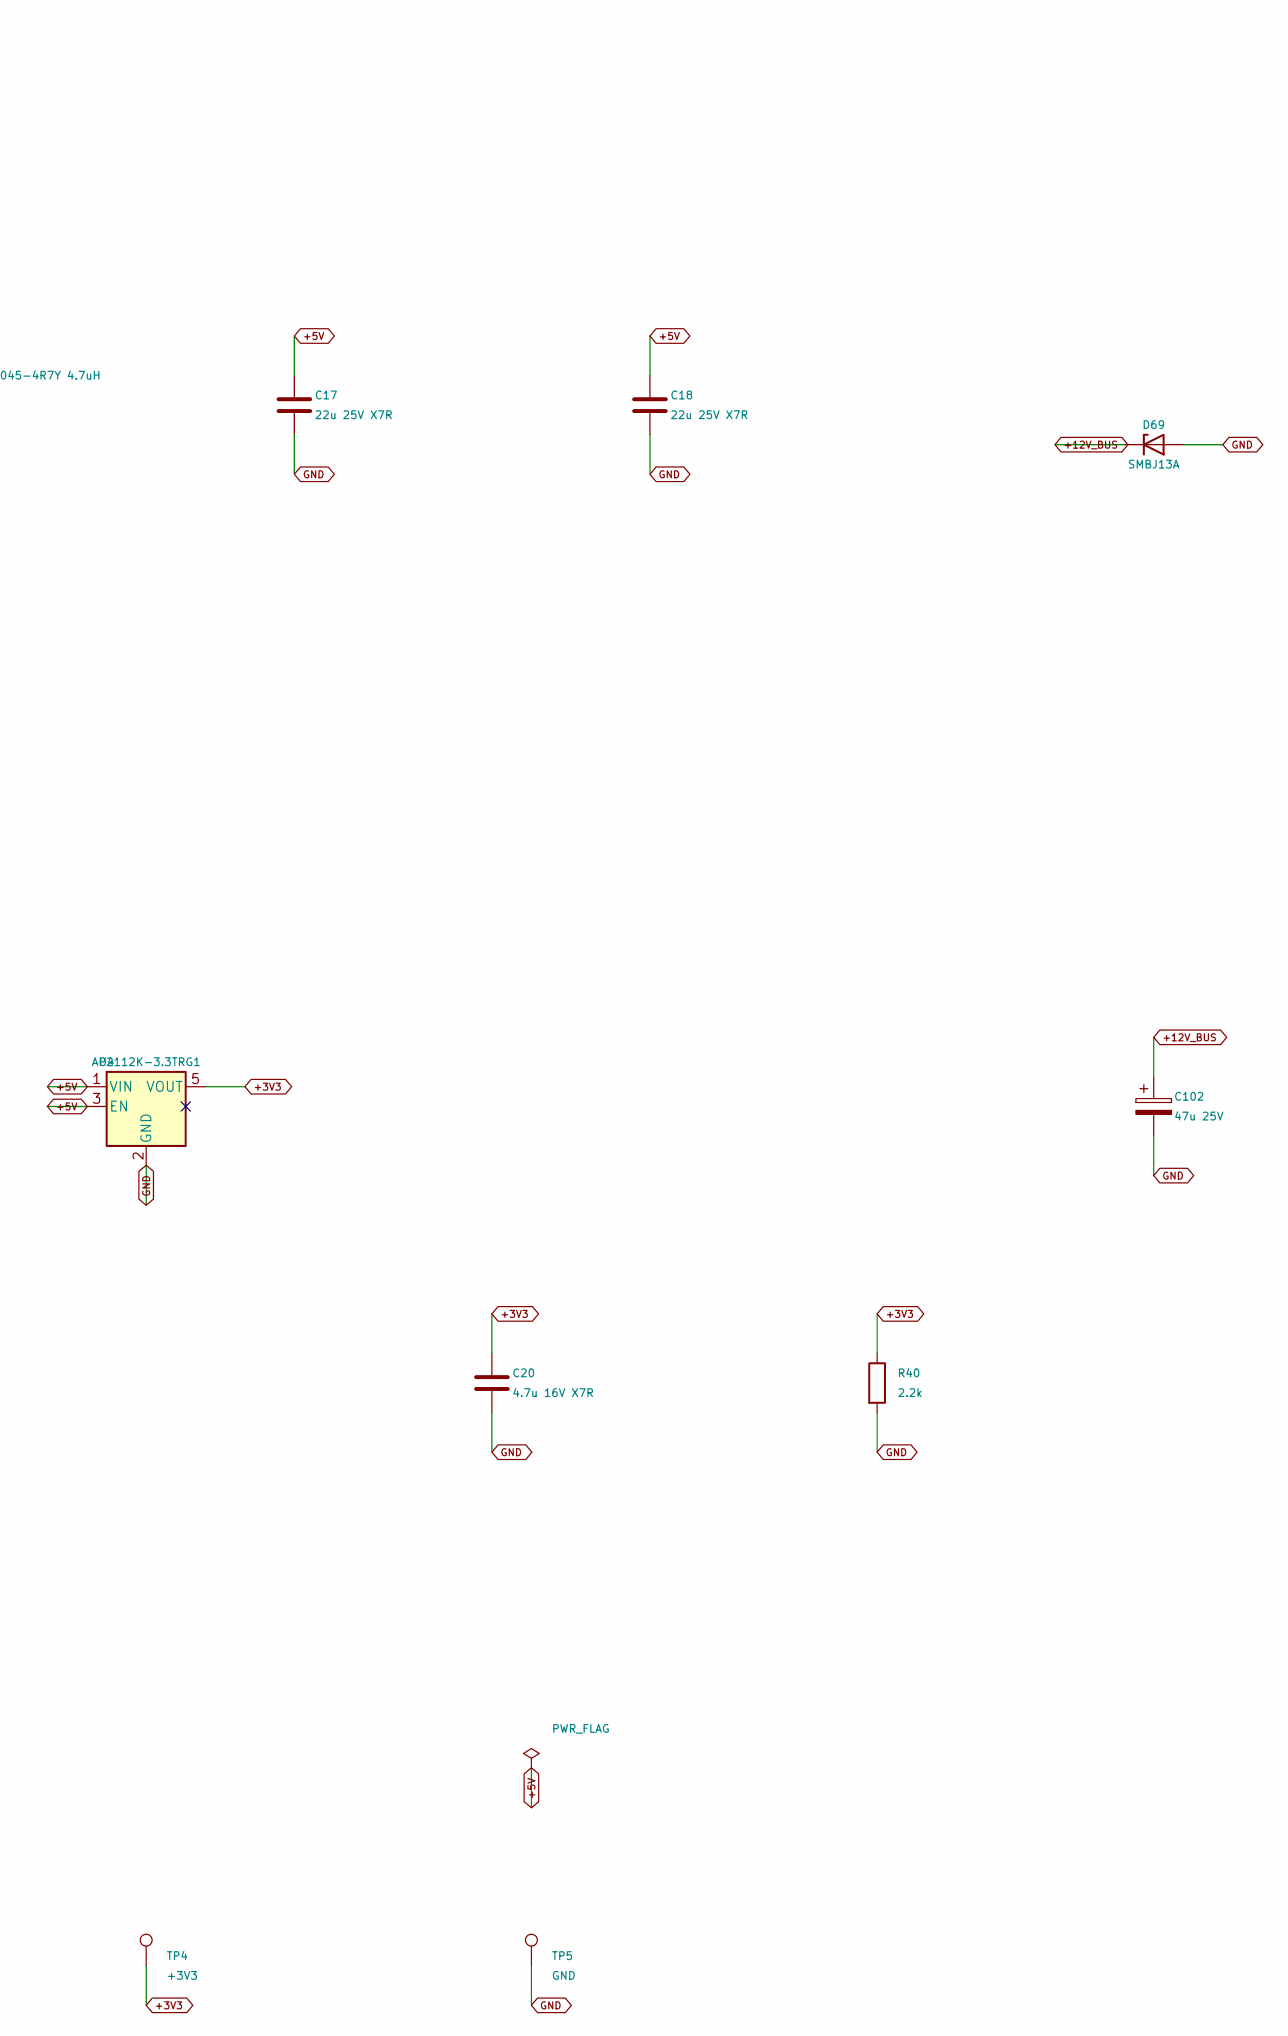
[picture p13: schematic power.kicad_sch, RGB Tiles, part in row 1, column 2]

Parts:
C15: 100n 25V X7R; C_0603_1608Metric; MPN CL10B104KA8NNNC
C16: 10u 50V X7R; C_1210_3225Metric; MPN CL32B106KBJNNNE
C17, C18: 22u 25V X7R; C_1210_3225Metric; MPN CL32B226KAJNNNE
C19, C20: 4.7u 16V X7R; C_0805_2012Metric; MPN C0805C475K4RACTU
C102: 47u 25V; CP_Elec_5x5.8; MPN EEEFT1E470AR
C105: 100n 50V X7R; C_0603_1608Metric; MPN C0603C104K5RACTU
D69: SMBJ13A; D_SMB; MPN SMBJ13A-13-F
F1: 1812L150/24MR; Fuse_1812_4532Metric; MPN 1812L150/24MR
L1: SRN6045-4R7Y 4.7uH; L_Bourns_SRN6045; MPN SRN6045-4R7Y
R5: 27.4k 1%; R_0603_1608Metric; Tolerance 1%; MPN RC0603FR-0727K4L
R6: 3.6k 1%; R_0603_1608Metric; Tolerance 1%; MPN RC0603FR-133K6L
R40: 2.2k; R_0603_1608Metric; Tolerance 1%; MPN RC0603FR-072K2L
TP1: +12V_BUS; TestPoint_Pad_D1.5mm
TP2: VIN_TILE; TestPoint_Pad_D1.5mm
TP3: +5V; TestPoint_Pad_D1.5mm
TP4: +3V3; TestPoint_Pad_D1.5mm
TP5: GND; TestPoint_Pad_D1.5mm
U3: AP63205WU-7; TSOT-23-6; MPN AP63205WU-7
U4: AP2112K-3.3TRG1; SOT-23-5; MPN AP2112K-3.3TRG1

Connections:
+3V3: C20.1, R40.1, TP4.1, U4.5 (VOUT); also elsewhere on the board
+5V: C17.1, C18.1, C19.1, L1.2, TP3.1, U3.1 (FB), U4.1 (VIN), U4.3 (EN); also elsewhere on the board
+12V_BUS: C102.1, D69.1 (K), F1.1, TP1.1; also elsewhere on the board
BST: C15.1, U3.6 (BST)
BUCK_EN: R5.2, R6.1, U3.2 (EN)
GND: C16.2, C17.2, C18.2, C19.2, C20.2, C102.2, C105.2, D69.2 (A), R6.2, R40.2, TP5.1, U3.4 (GND), U4.2 (GND); also elsewhere on the board
SW: C15.2, L1.1, U3.5 (SW)
VIN_TILE: C16.1, C105.1, F1.2, R5.1, TP2.1, U3.3 (IN)

Notes on the sheet:
POWER
