EwoudVV/rgb-tiles/rgb-tiles.kicad_pcb

## KiCad design rgb-tiles.kicad_pcb (continued)

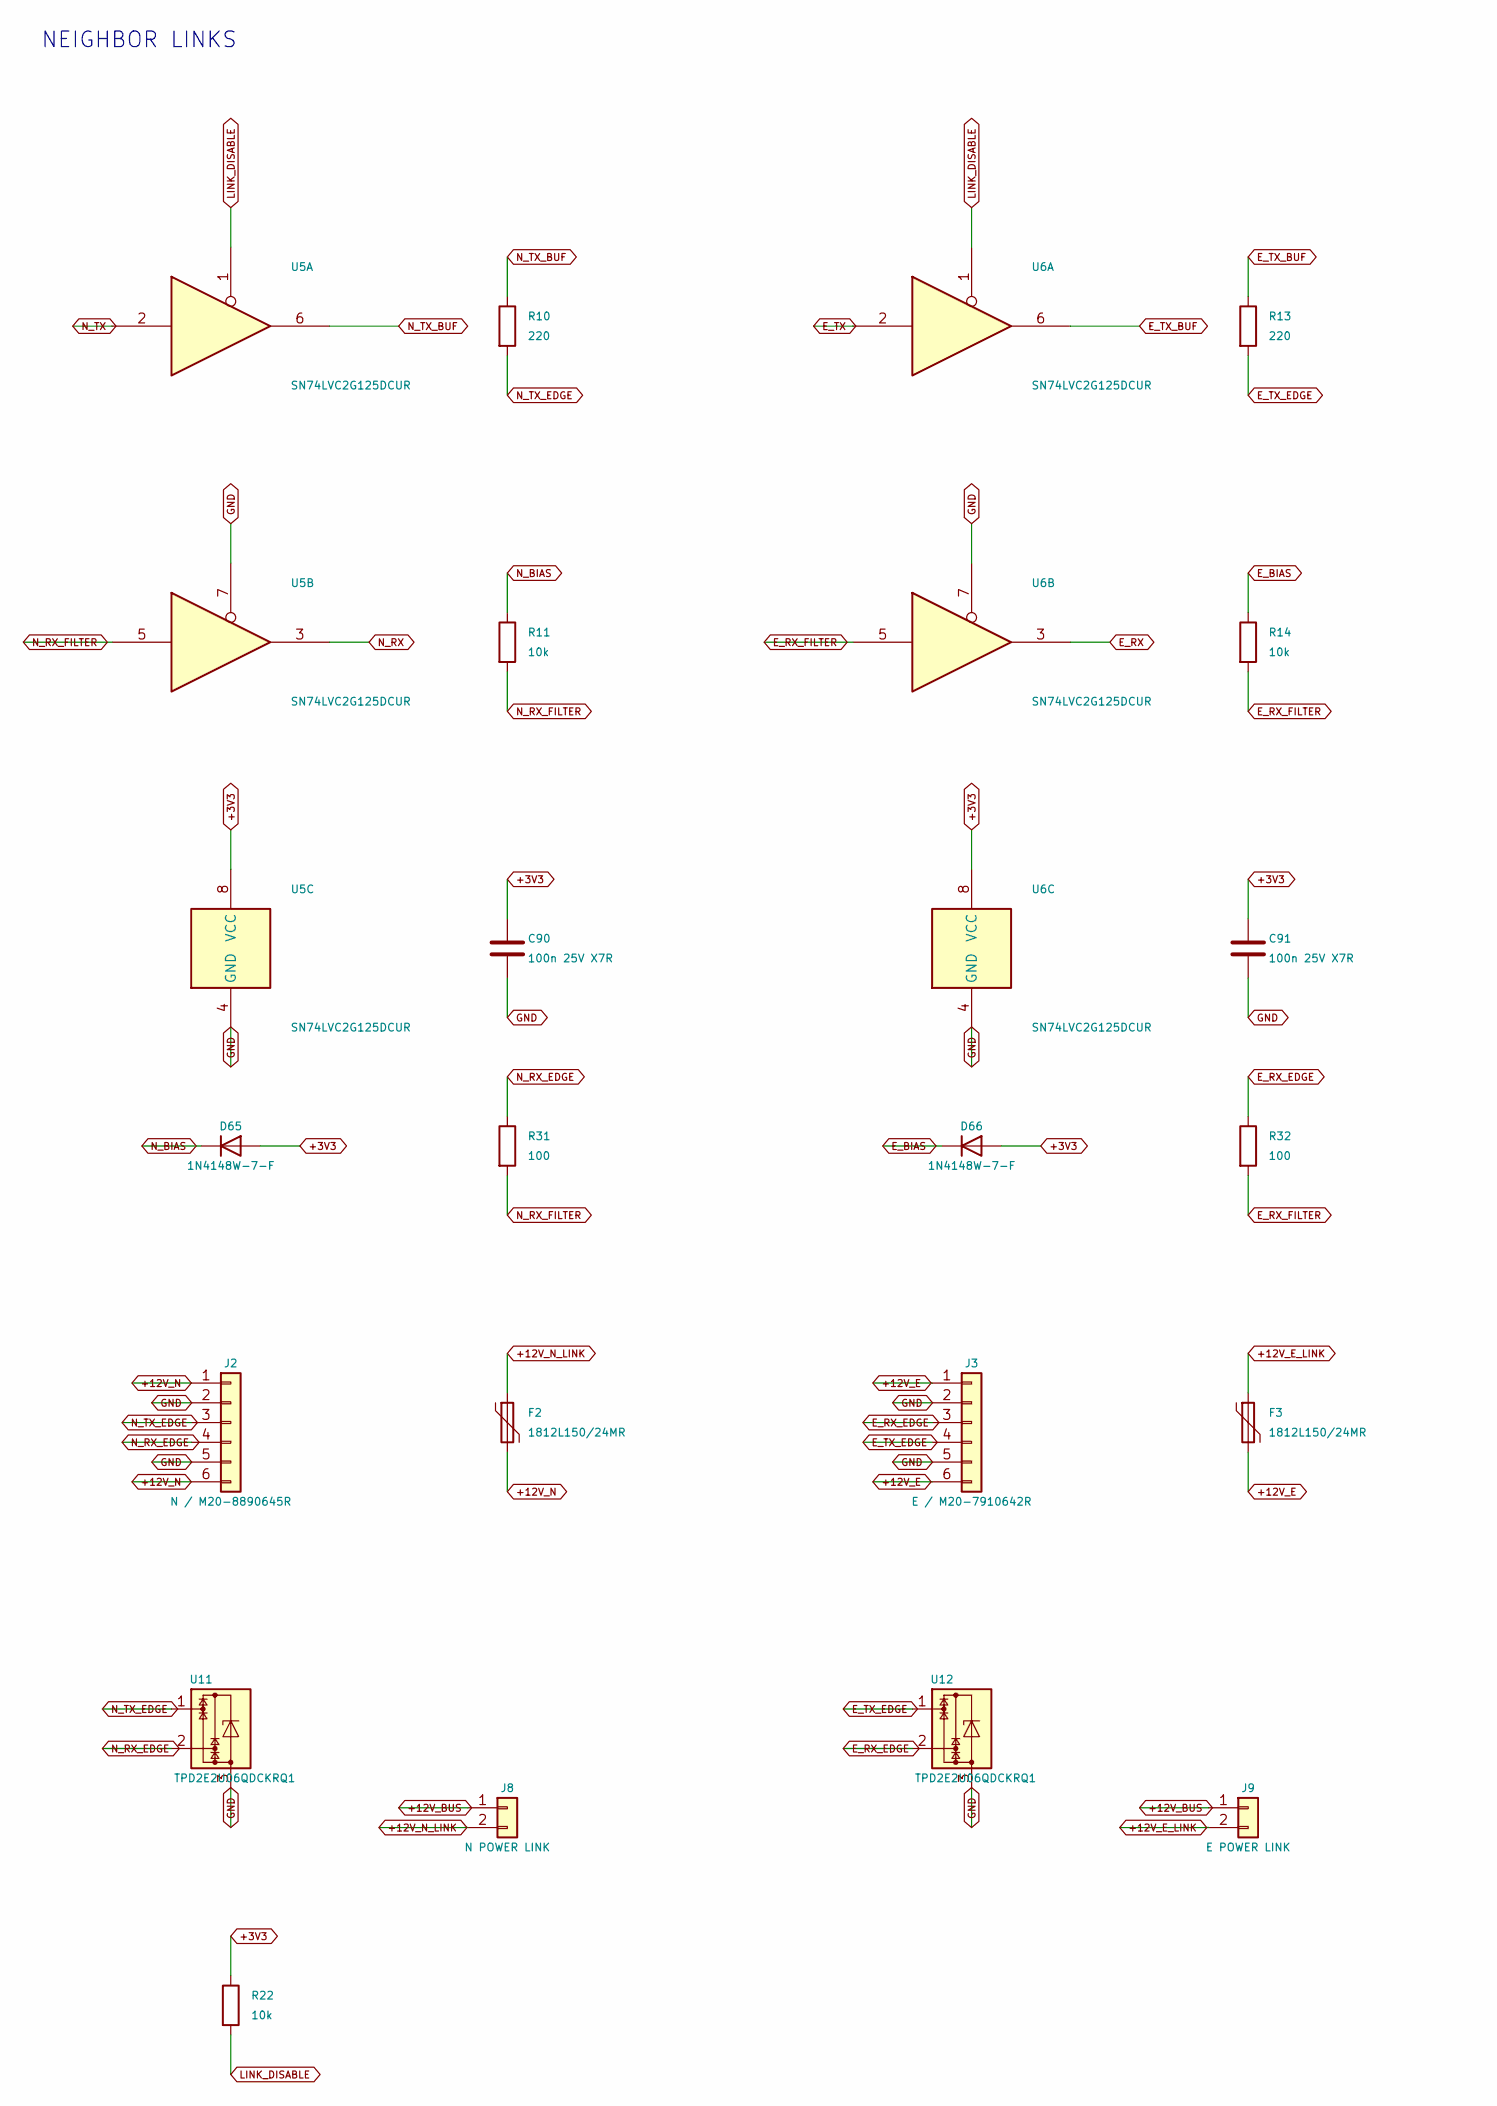
[picture p14: schematic interfaces.kicad_sch, RGB Tiles, part in row 1, column 1]

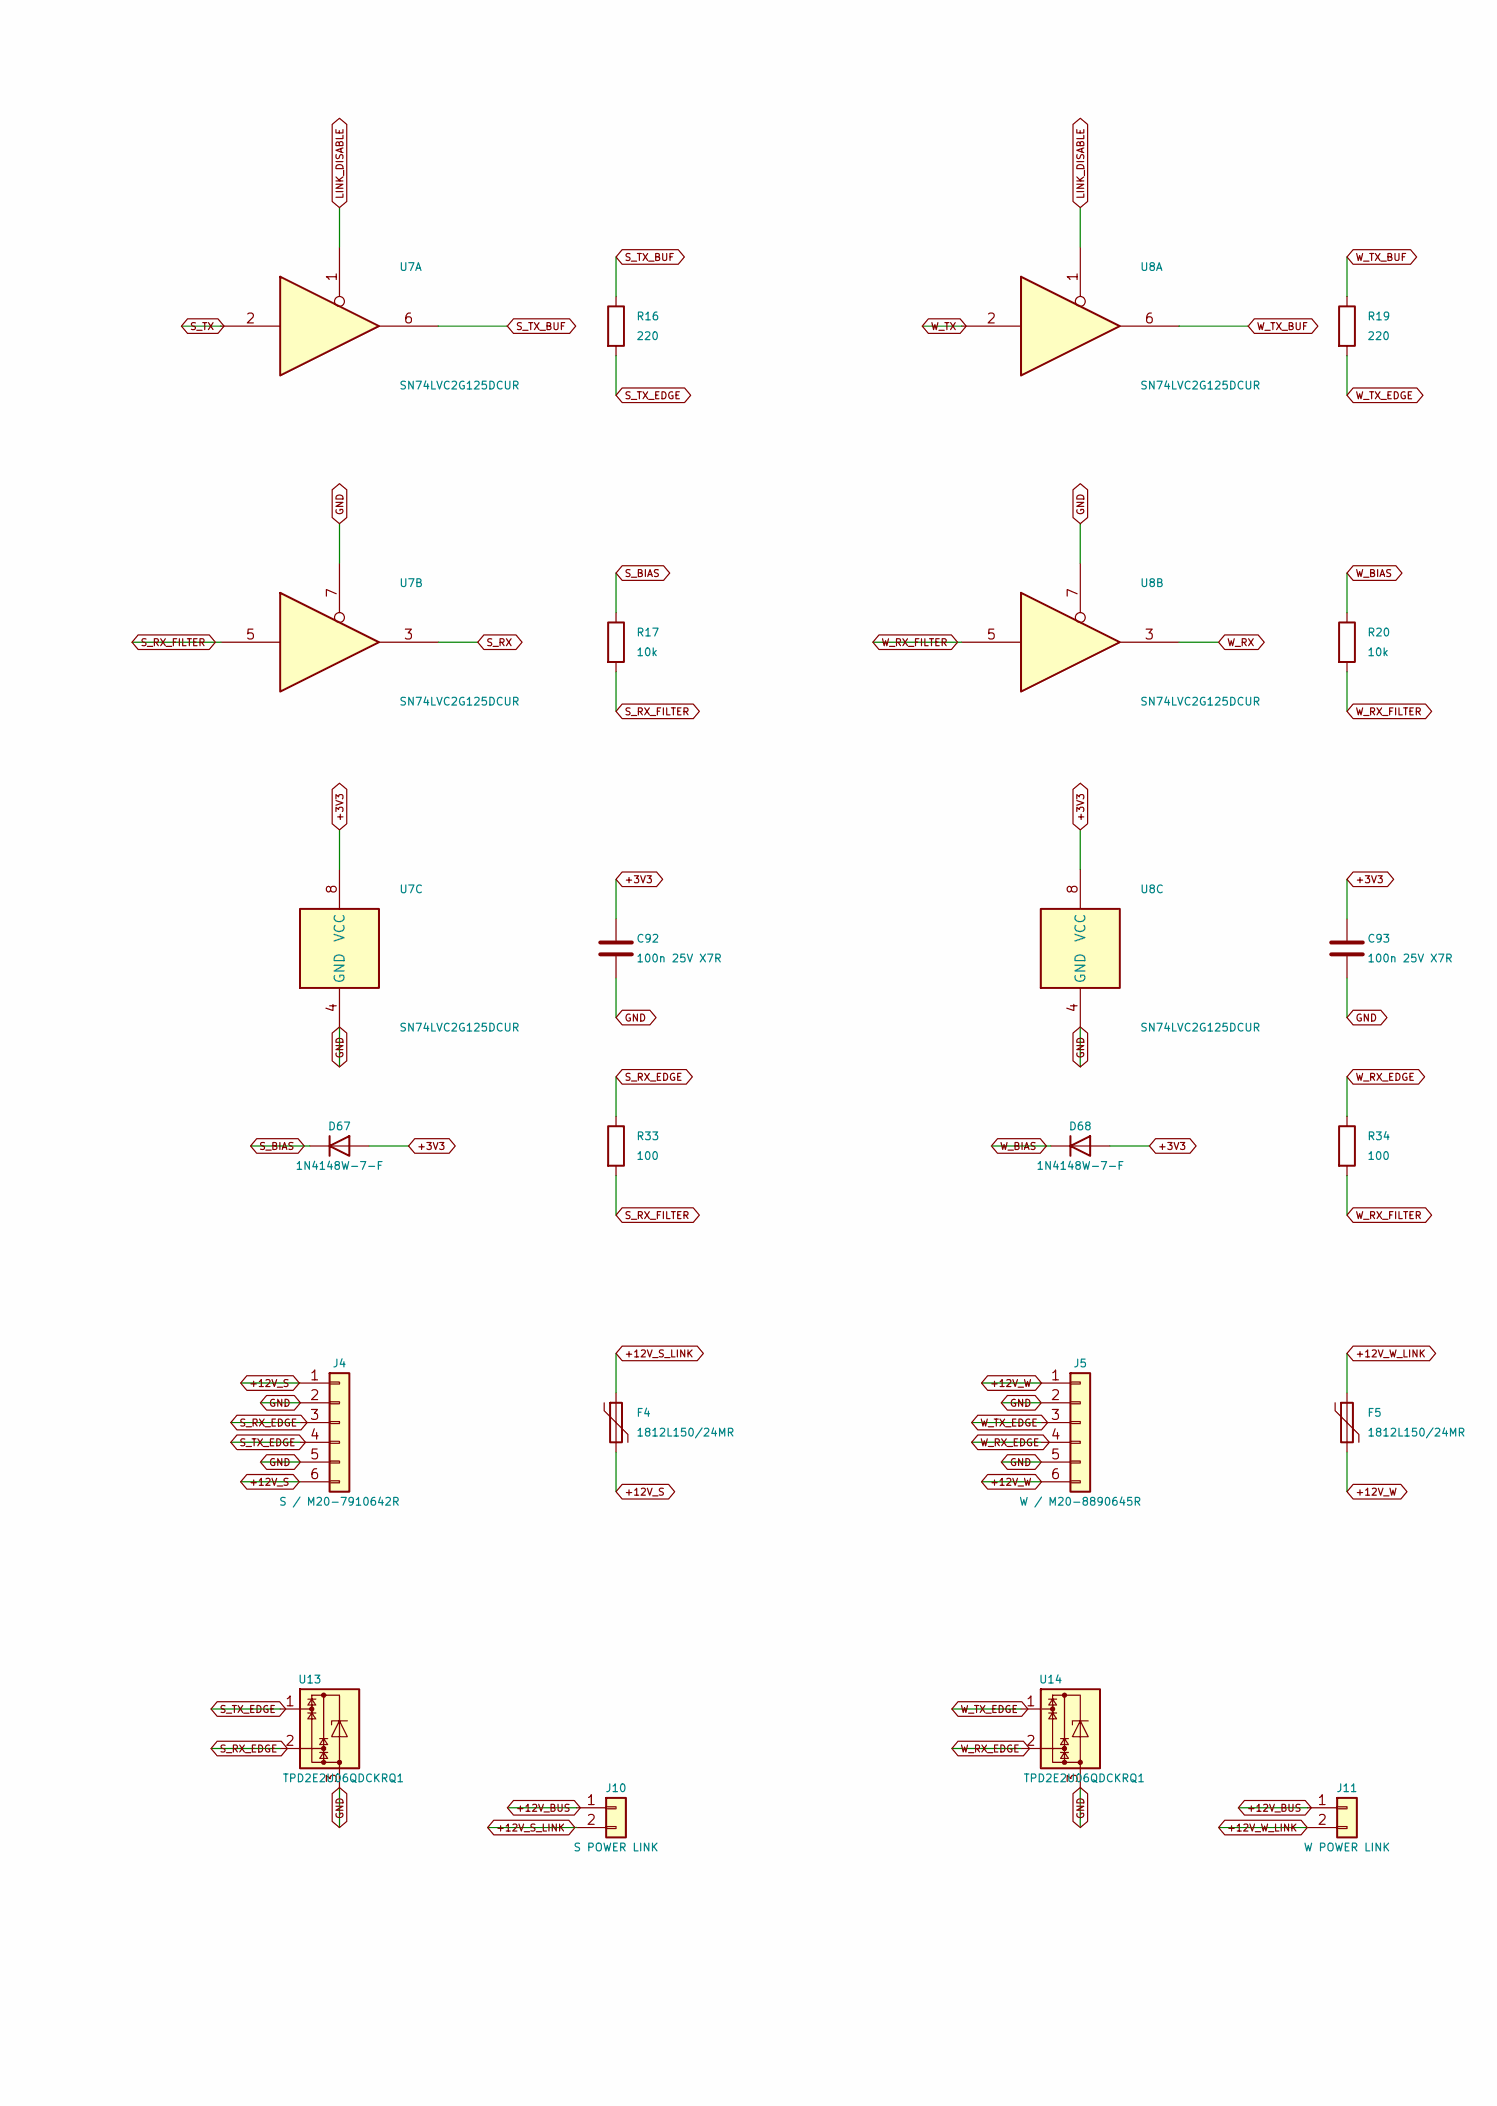
[picture p15: schematic interfaces.kicad_sch, RGB Tiles, part in row 1, column 2]

Parts:
C90, C91, C92, C93: 100n 25V X7R; C_0603_1608Metric; MPN CL10B104KA8NNNC
D65, D66, D67, D68: 1N4148W-7-F; D_SOD-123; MPN 1N4148W-7-F
F2, F3, F4, F5: 1812L150/24MR; Fuse_1812_4532Metric; MPN 1812L150/24MR
J2: N / M20-8890645R; Harwin_M20-8890645R_1x06_RA_SMD; MPN M20-8890645R
J3: E / M20-7910642R; Harwin_M20-7910642R_1x06_RA_SMD; MPN M20-7910642R
J4: S / M20-7910642R; Harwin_M20-7910642R_1x06_RA_SMD; MPN M20-7910642R
J5: W / M20-8890645R; Harwin_M20-8890645R_1x06_RA_SMD; MPN M20-8890645R
J8: N POWER LINK; PinHeader_1x02_P2.54mm_Vertical; MPN A2541WV-2P
J9: E POWER LINK; PinHeader_1x02_P2.54mm_Vertical; MPN A2541WV-2P
J10: S POWER LINK; PinHeader_1x02_P2.54mm_Vertical; MPN A2541WV-2P
J11: W POWER LINK; PinHeader_1x02_P2.54mm_Vertical; MPN A2541WV-2P
R10, R13, R16, R19: 220; R_0603_1608Metric; Tolerance 1%; MPN RC0603FR-07220RL
R11, R14, R17, R20, R22: 10k; R_0603_1608Metric; Tolerance 1%; MPN RC0603FR-0710KL
R31, R32, R33, R34: 100; R_0603_1608Metric; Tolerance 1%; MPN RC0603FR-07100RL
U5, U6, U7, U8: SN74LVC2G125DCUR; VSSOP-8_2.3x2mm_P0.5mm; MPN SN74LVC2G125DCUR
U11, U12, U13, U14: TPD2E2U06QDCKRQ1; SOT-323_SC-70; MPN TPD2E2U06QDCKRQ1

Connections:
+3V3: C90.1, C91.1, C92.1, C93.1, D65.2 (A), D66.2 (A), D67.2 (A), D68.2 (A), R22.1, U5.8 (VCC), U6.8 (VCC), U7.8 (VCC), U8.8 (VCC); also elsewhere on the board
+12V_BUS: J8.1, J9.1, J10.1, J11.1; also elsewhere on the board
+12V_E: F3.2, J3.1, J3.6
+12V_E_LINK: F3.1, J9.2
+12V_N: F2.2, J2.1, J2.6
+12V_N_LINK: F2.1, J8.2
+12V_S: F4.2, J4.1, J4.6
+12V_S_LINK: F4.1, J10.2
+12V_W: F5.2, J5.1, J5.6
+12V_W_LINK: F5.1, J11.2
E_BIAS: D66.1 (K), R14.1
E_RX: U6.3; also elsewhere on the board
E_RX_EDGE: J3.3, R32.1, U12.2
E_RX_FILTER: R14.2, R32.2, U6.5
E_TX: U6.2; also elsewhere on the board
E_TX_BUF: R13.1, U6.6
E_TX_EDGE: J3.4, R13.2, U12.1
GND: C90.2, C91.2, C92.2, C93.2, J2.2, J2.5, J3.2, J3.5, J4.2, J4.5, J5.2, J5.5, U5.4 (GND), U5.7, U6.4 (GND), U6.7, U7.4 (GND), U7.7, U8.4 (GND), U8.7, U11.3, U12.3, U13.3, U14.3; also elsewhere on the board
LINK_DISABLE: R22.2, U5.1, U6.1, U7.1, U8.1; also elsewhere on the board
N_BIAS: D65.1 (K), R11.1
N_RX: U5.3; also elsewhere on the board
N_RX_EDGE: J2.4, R31.1, U11.2
N_RX_FILTER: R11.2, R31.2, U5.5
N_TX: U5.2; also elsewhere on the board
N_TX_BUF: R10.1, U5.6
N_TX_EDGE: J2.3, R10.2, U11.1
S_BIAS: D67.1 (K), R17.1
S_RX: U7.3; also elsewhere on the board
S_RX_EDGE: J4.3, R33.1, U13.2
S_RX_FILTER: R17.2, R33.2, U7.5
S_TX: U7.2; also elsewhere on the board
S_TX_BUF: R16.1, U7.6
S_TX_EDGE: J4.4, R16.2, U13.1
W_BIAS: D68.1 (K), R20.1
W_RX: U8.3; also elsewhere on the board
W_RX_EDGE: J5.4, R34.1, U14.2
W_RX_FILTER: R20.2, R34.2, U8.5
W_TX: U8.2; also elsewhere on the board
W_TX_BUF: R19.1, U8.6
W_TX_EDGE: J5.3, R19.2, U14.1

Notes on the sheet:
NEIGHBOR LINKS

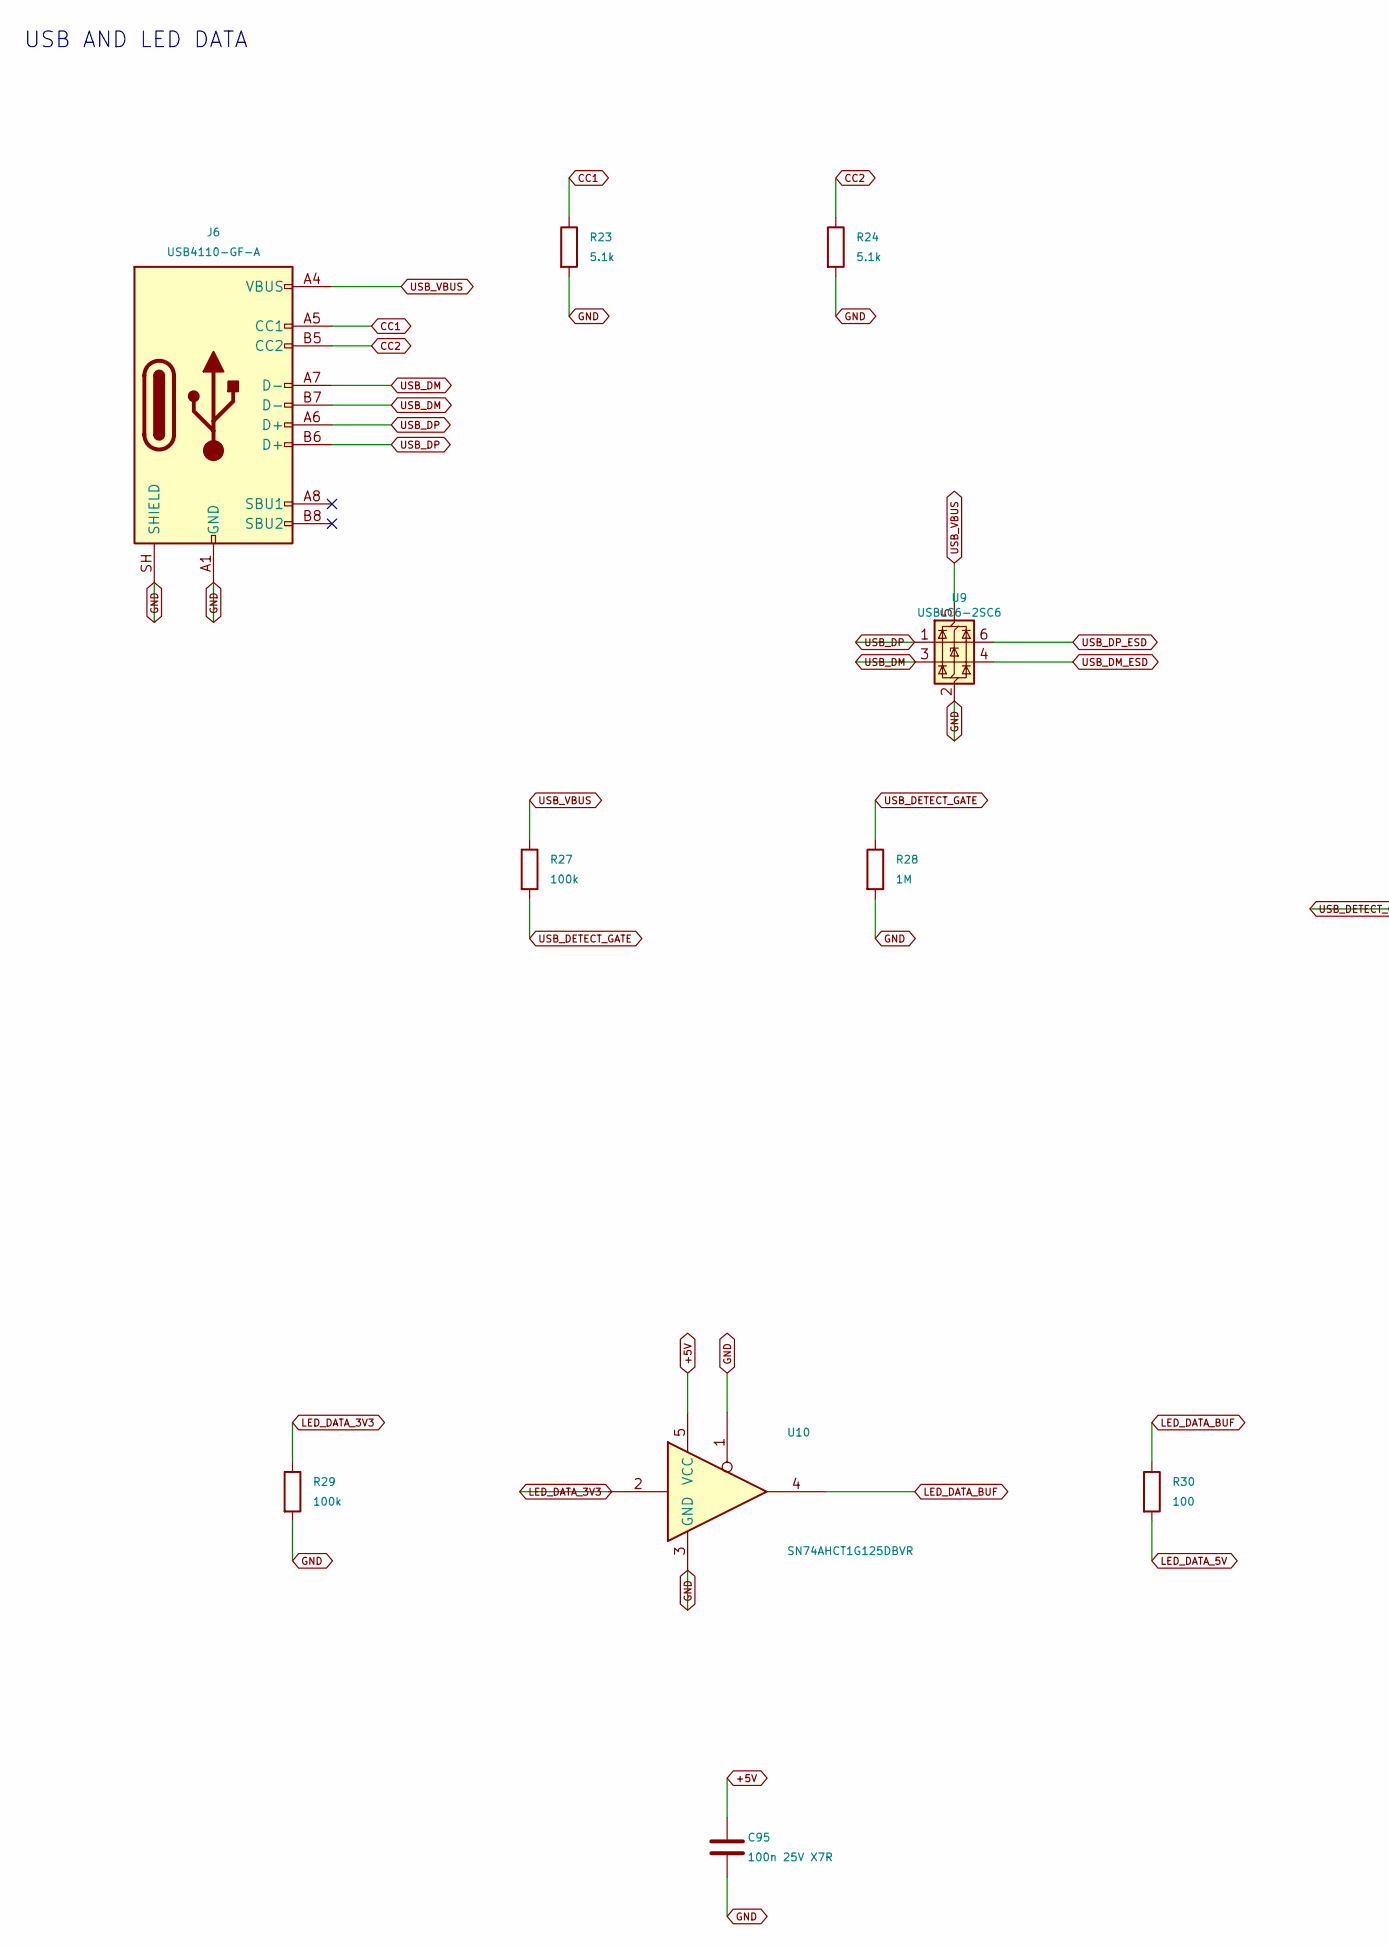
[picture p16: schematic usb-led-data.kicad_sch, RGB Tiles, part in row 1, column 1]

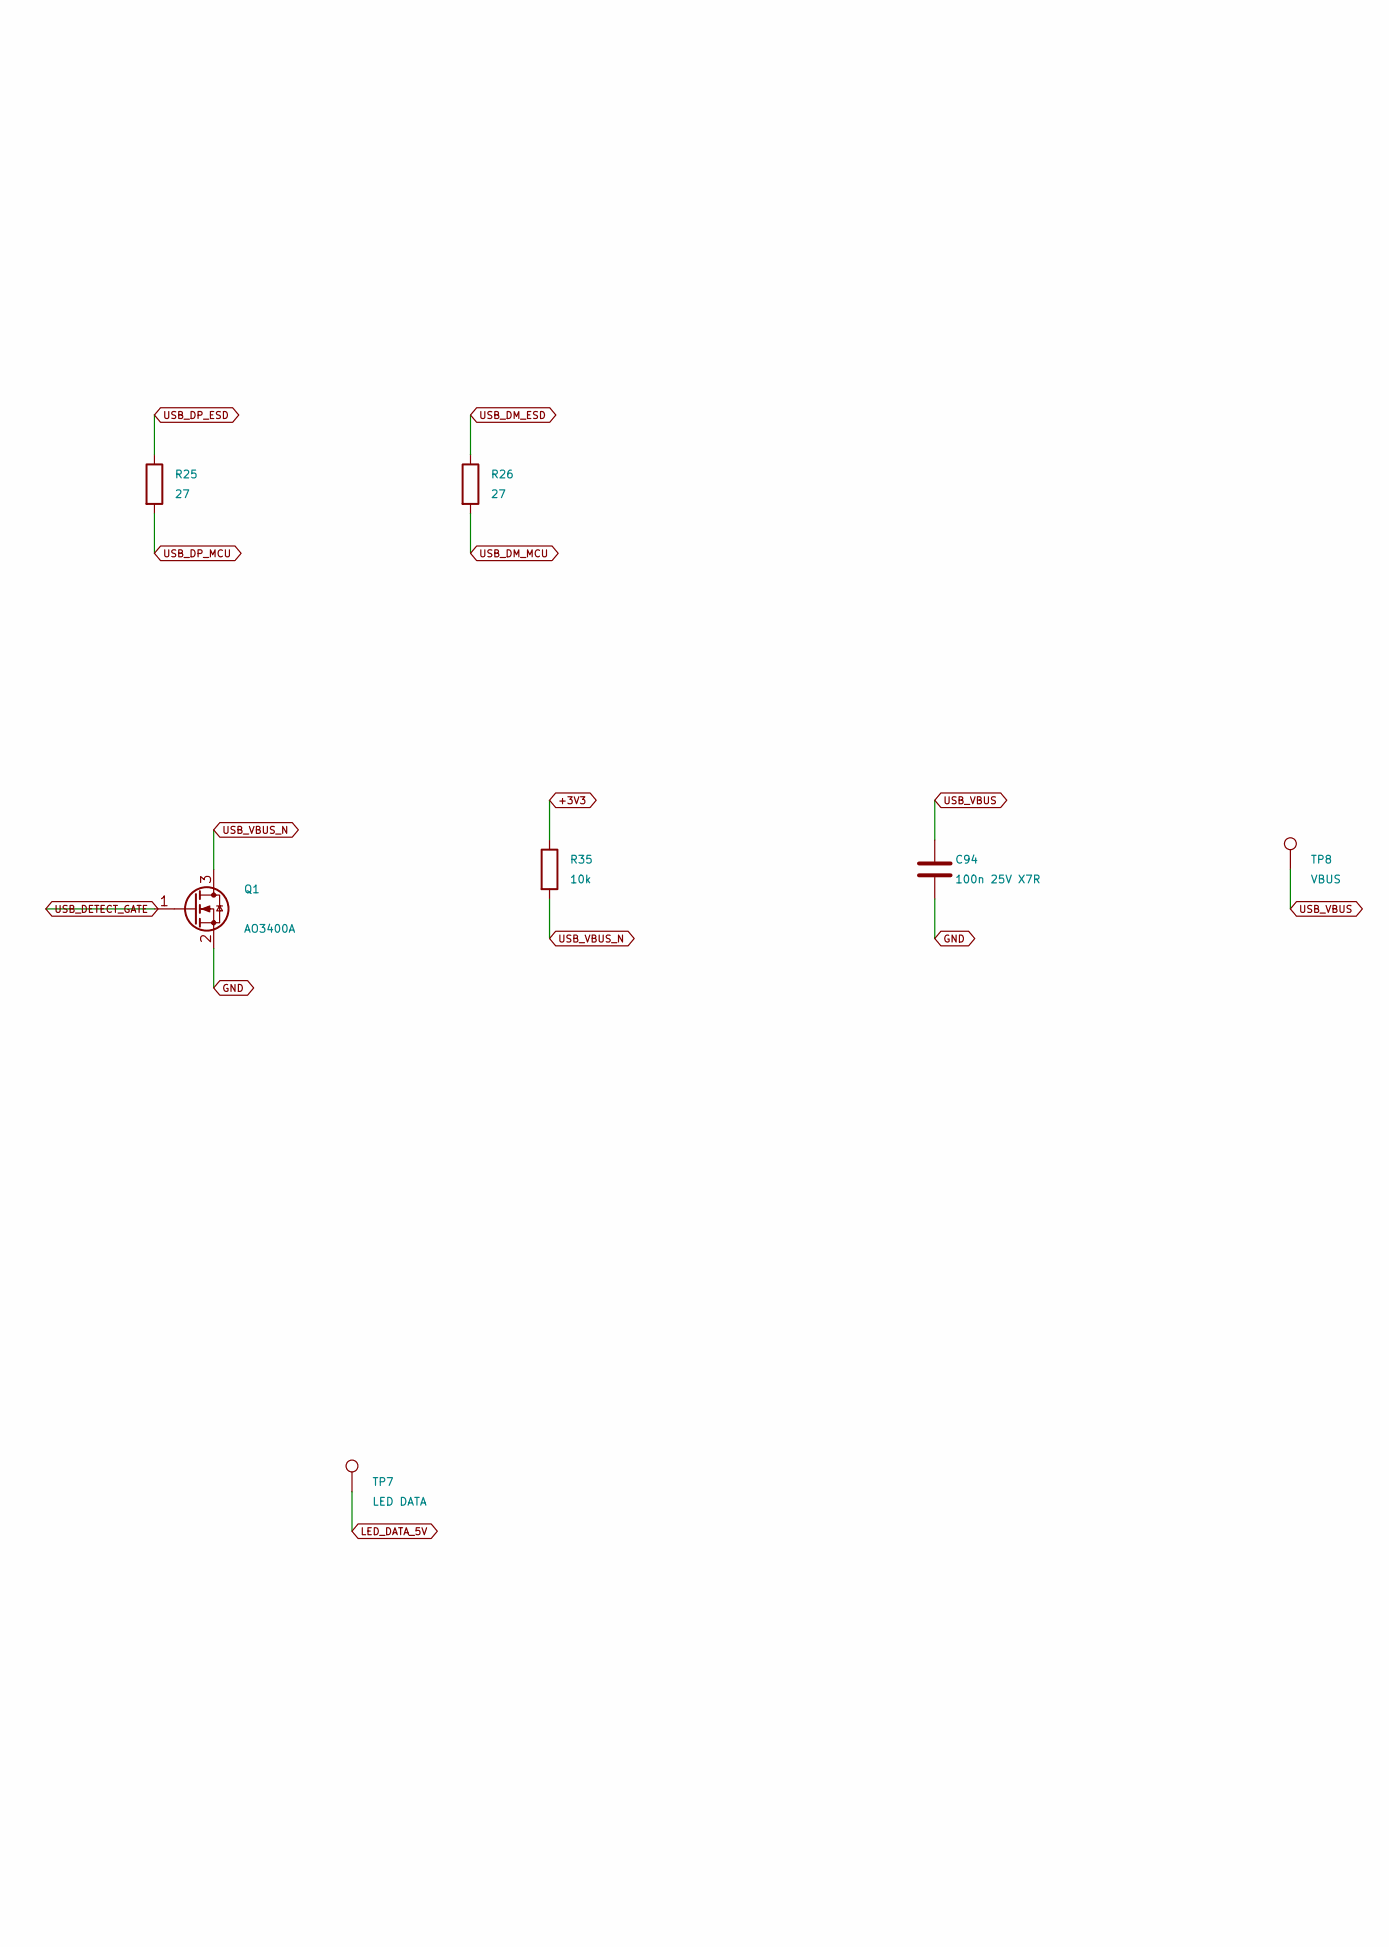
[picture p17: schematic usb-led-data.kicad_sch, RGB Tiles, part in row 1, column 2]

Parts:
C94, C95: 100n 25V X7R; C_0603_1608Metric; MPN CL10B104KA8NNNC
J6: USB4110-GF-A; USB_C_Receptacle_GCT_USB4110; MPN USB4110-GF-A
Q1: AO3400A; SOT-23; MPN AO3400A
R23, R24: 5.1k; R_0603_1608Metric; Tolerance 1%; MPN RC0603FR-075K1L
R25, R26: 27; R_0603_1608Metric; Tolerance 1%; MPN RC0603FR-0727RL
R27, R29: 100k; R_0603_1608Metric; Tolerance 1%; MPN RC0603FR-07100KL
R28: 1M; R_0603_1608Metric; Tolerance 1%; MPN RC0603FR-071ML
R30: 100; R_0603_1608Metric; Tolerance 1%; MPN RC0603FR-07100RL
R35: 10k; R_0603_1608Metric; Tolerance 1%; MPN RC0603FR-0710KL
TP7: LED DATA; TestPoint_Pad_D1.5mm
TP8: VBUS; TestPoint_Pad_D1.5mm
U9: USBLC6-2SC6; SOT-23-6; MPN USBLC6-2SC6
U10: SN74AHCT1G125DBVR; SOT-23-5; MPN SN74AHCT1G125DBVR

Connections:
+3V3: R35.1; also elsewhere on the board
+5V: C95.1, U10.5 (VCC); also elsewhere on the board
CC1: J6.A5 (CC1), R23.1
CC2: J6.B5 (CC2), R24.1
GND: C94.2, C95.2, J6.A1 (GND), J6.A12 (GND), J6.B1 (GND), J6.B12 (GND), J6.SH (SHIELD), Q1.2 (S), R23.2, R24.2, R28.2, R29.2, U9.2 (GND), U10.1, U10.3 (GND); also elsewhere on the board
LED_DATA_3V3: R29.1, U10.2; also elsewhere on the board
LED_DATA_5V: R30.2, TP7.1; also elsewhere on the board
LED_DATA_BUF: R30.1, U10.4
USB_DETECT_GATE: Q1.1 (G), R27.2, R28.1
USB_DM: J6.A7 (D-), J6.B7 (D-), U9.3 (I/O2)
USB_DM_ESD: R26.1, U9.4 (I/O2)
USB_DM_MCU: R26.2; also elsewhere on the board
USB_DP: J6.A6 (D+), J6.B6 (D+), U9.1 (I/O1)
USB_DP_ESD: R25.1, U9.6 (I/O1)
USB_DP_MCU: R25.2; also elsewhere on the board
USB_VBUS: C94.1, J6.A4 (VBUS), J6.A9 (VBUS), J6.B4 (VBUS), J6.B9 (VBUS), R27.1, TP8.1, U9.5 (VBUS)
USB_VBUS_N: Q1.3 (D), R35.2; also elsewhere on the board

Notes on the sheet:
USB AND LED DATA

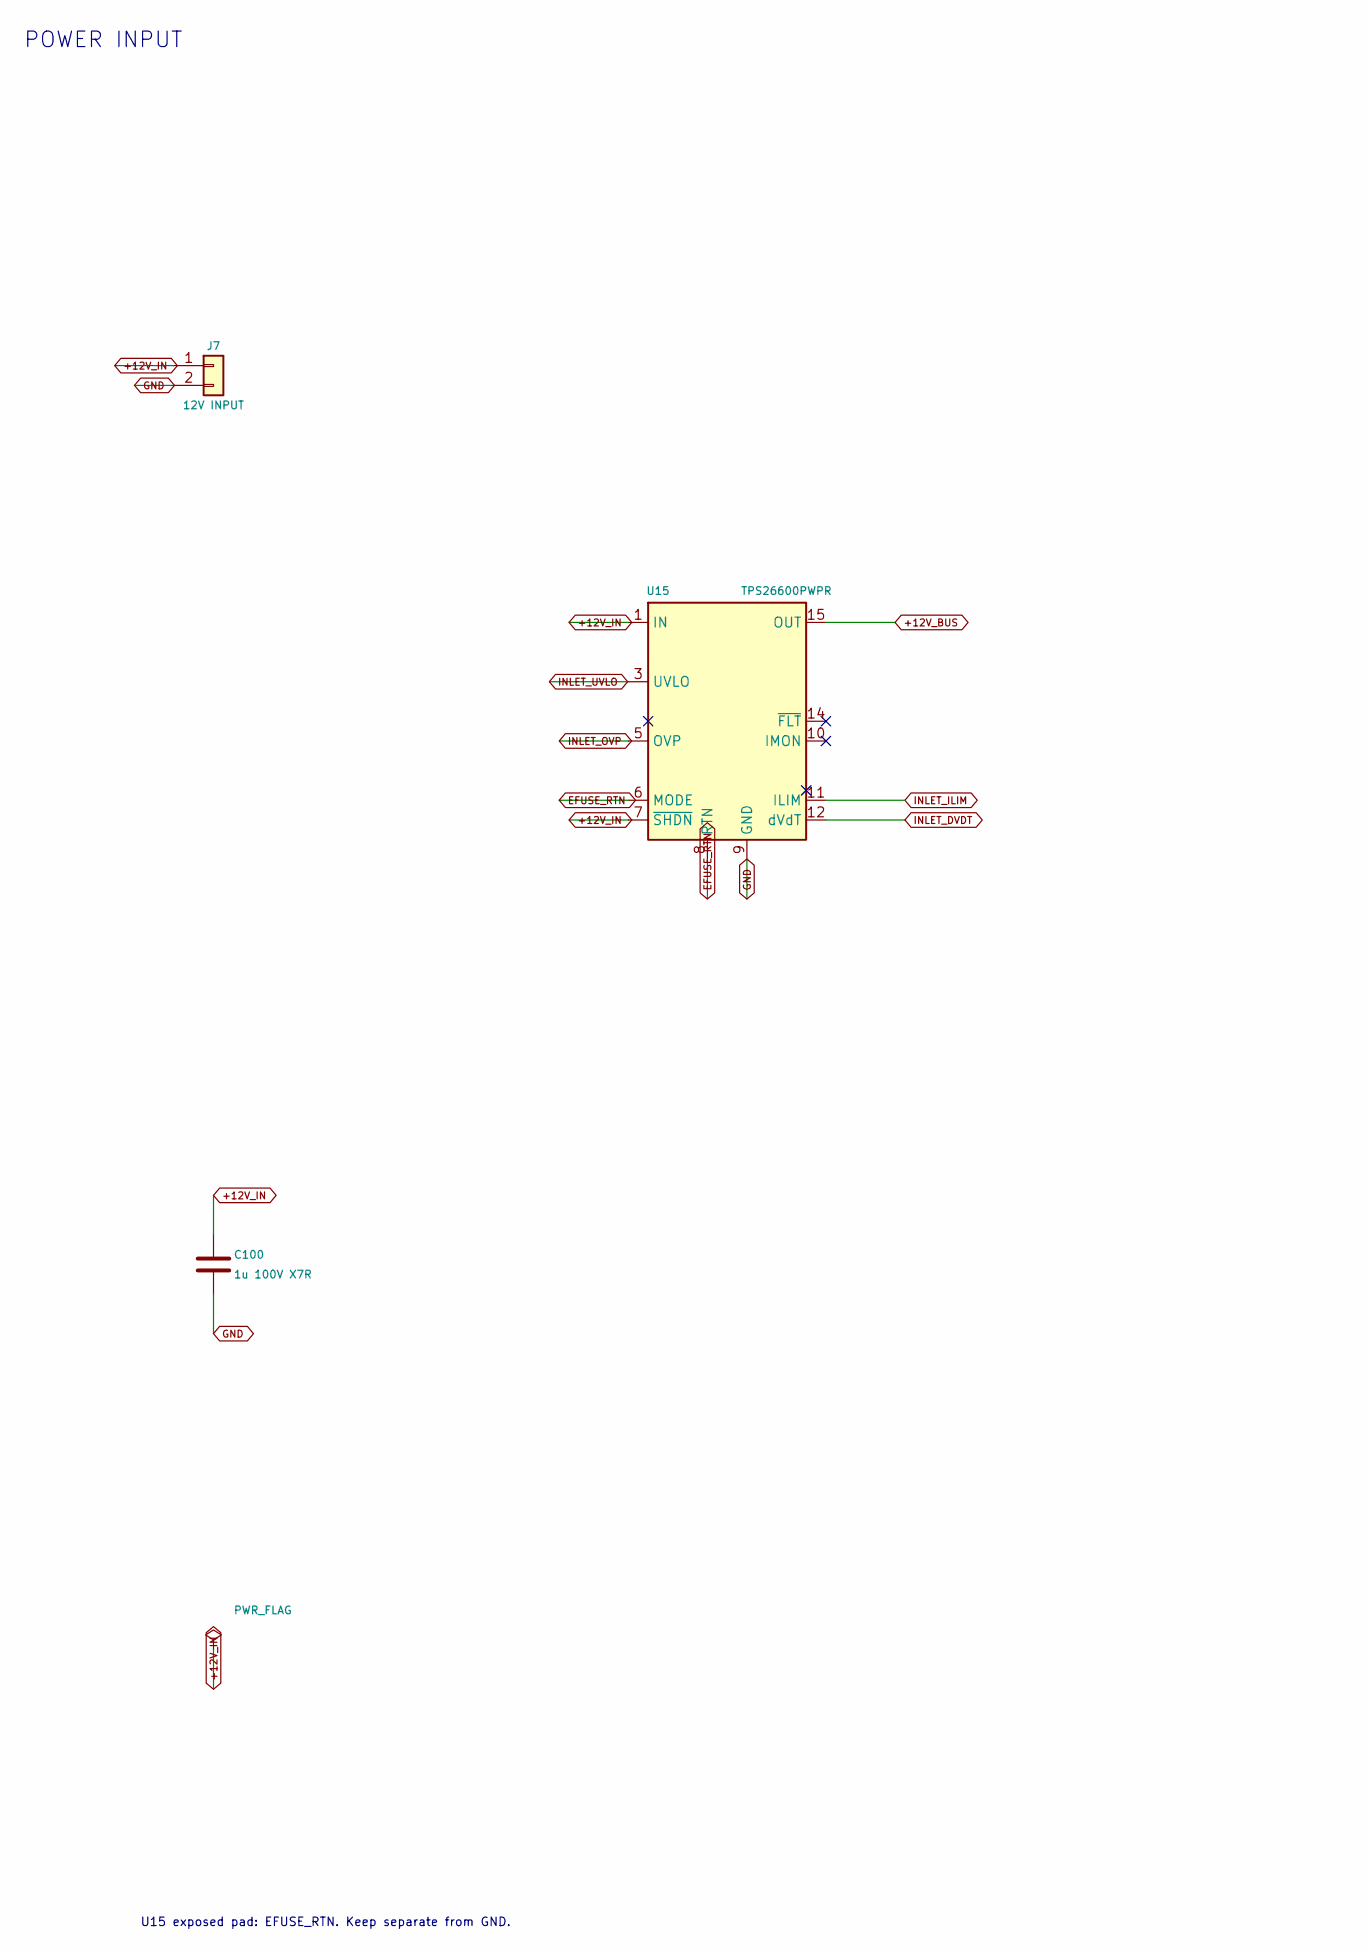
[picture p18: schematic power-inlet.kicad_sch, RGB Tiles, part in row 1, column 1]

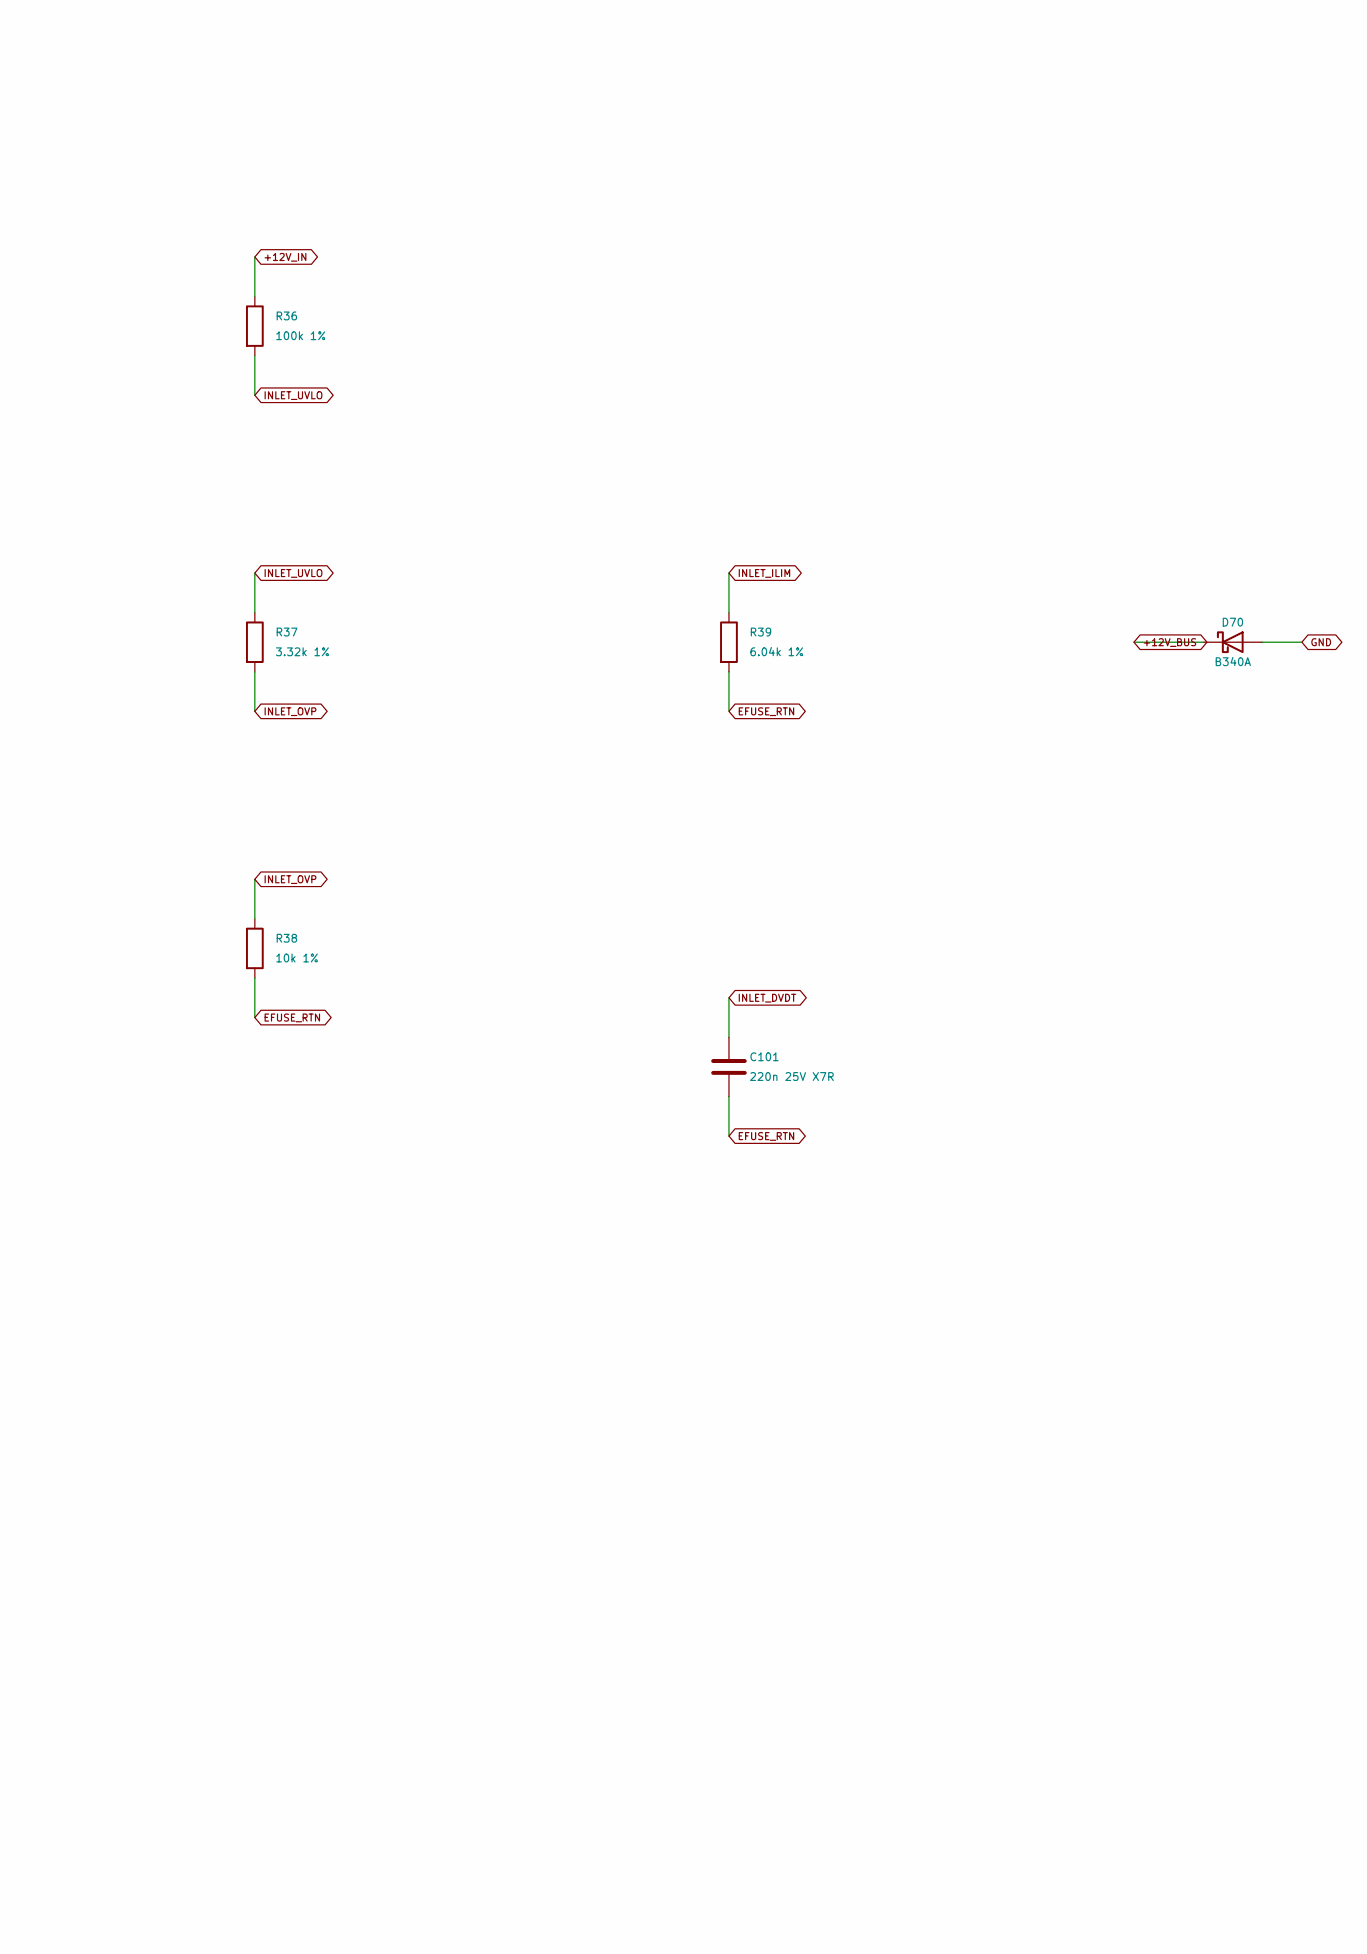
[picture p19: schematic power-inlet.kicad_sch, RGB Tiles, part in row 1, column 2]

Parts:
C100: 1u 100V X7R; C_1206_3216Metric; MPN C1206C105K1RACTU
C101: 220n 25V X7R; C_0603_1608Metric; MPN C0603C224K3RACTU
D70: B340A; D_SMA; MPN B340A-13-F
J7: 12V INPUT; TerminalBlock_Phoenix_MKDS-1,5-2-5.08_1x02_P5.08mm_Horizont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; MPN 1715721
R36: 100k 1%; R_0603_1608Metric; Tolerance 1%; MPN RC0603FR-07100KL
R37: 3.32k 1%; R_0603_1608Metric; Tolerance 1%; MPN RC0603FR-073K32L
R38: 10k 1%; R_0603_1608Metric; Tolerance 1%; MPN RC0603FR-0710KL
R39: 6.04k 1%; R_0603_1608Metric; Tolerance 1%; MPN RC0603FR-076K04L
U15: TPS26600PWPR; HTSSOP16_EP_4.4x5_P0.65_Vias0.3; MPN TPS26600PWPR

Connections:
+12V_BUS: D70.1 (K), U15.15 (OUT), U15.16 (OUT); also elsewhere on the board
+12V_IN: C100.1, J7.1, R36.1, U15.1 (IN), U15.2 (IN), U15.7 (~SHDN)
EFUSE_RTN: C101.2, R38.2, R39.2, U15.6 (MODE), U15.8 (RTN), U15.17 (RTN)
GND: C100.2, D70.2 (A), J7.2, U15.9 (GND); also elsewhere on the board
INLET_DVDT: C101.1, U15.12 (dVdT)
INLET_ILIM: R39.1, U15.11 (ILIM)
INLET_OVP: R37.2, R38.1, U15.5 (OVP)
INLET_UVLO: R36.2, R37.1, U15.3 (UVLO)

Notes on the sheet:
POWER INPUT
U15 exposed pad: EFUSE_RTN. Keep separate from GND.
