EwoudVV/rgb-tiles/rgb-tiles.kicad_pcb

## KiCad design rgb-tiles.kicad_pcb (continued)

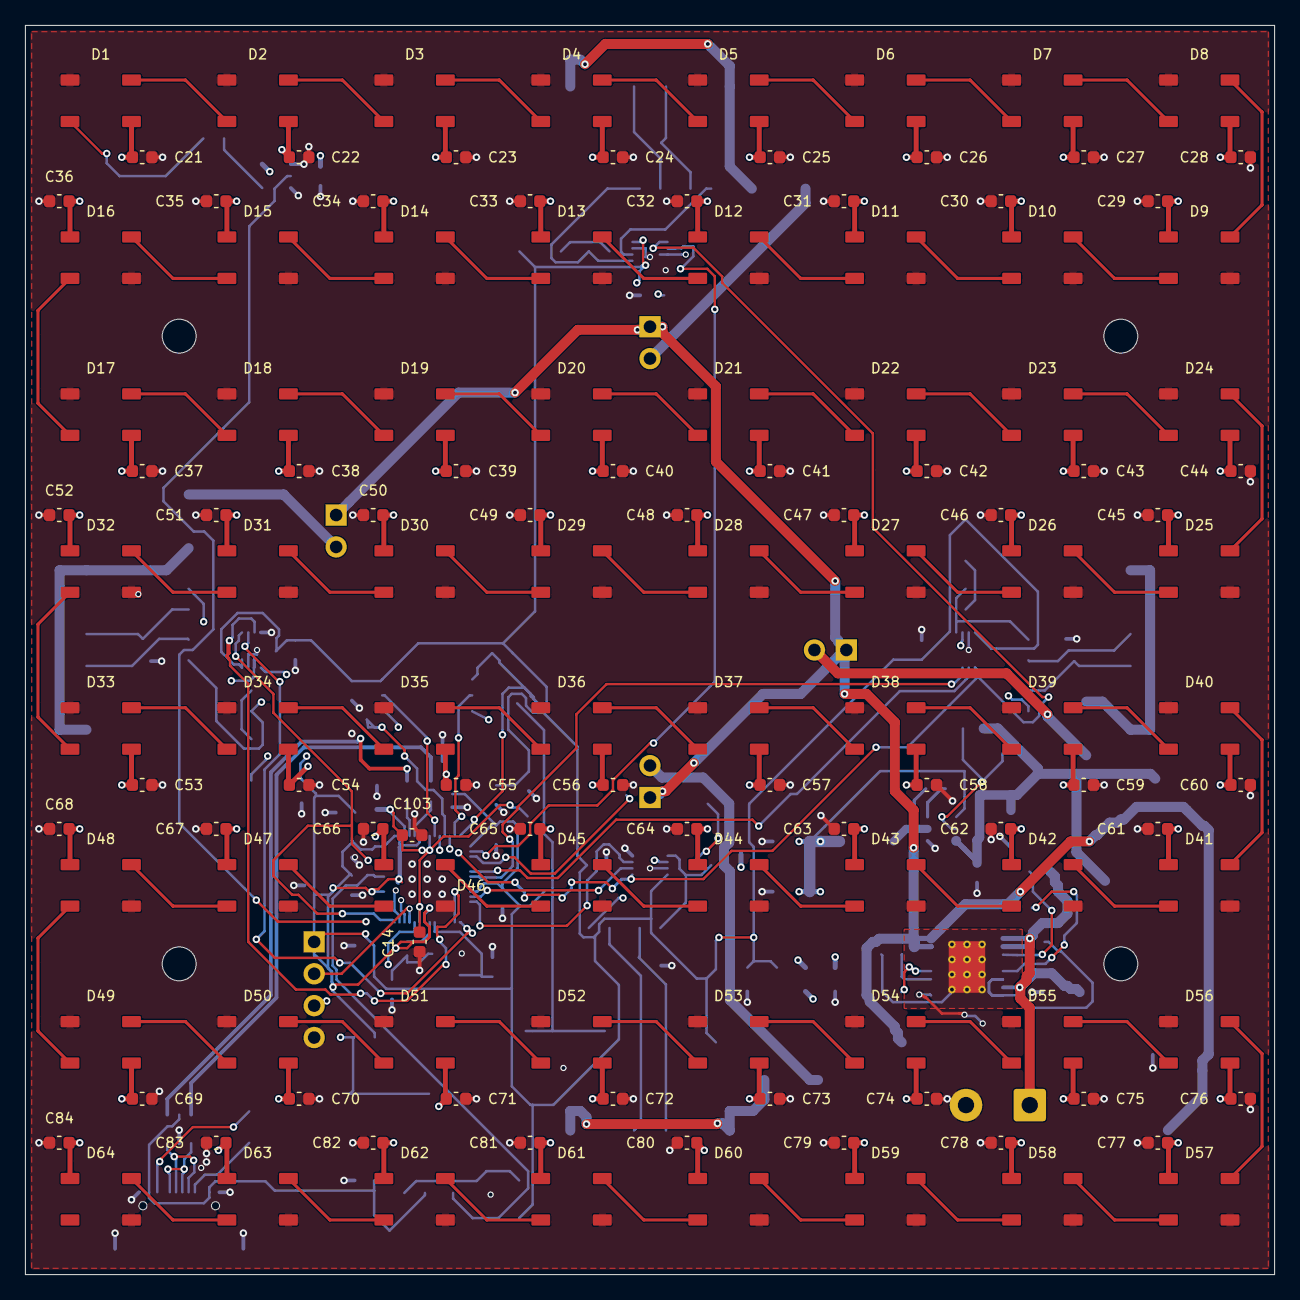
[picture p20: board rgb-tiles.kicad_pcb from above]

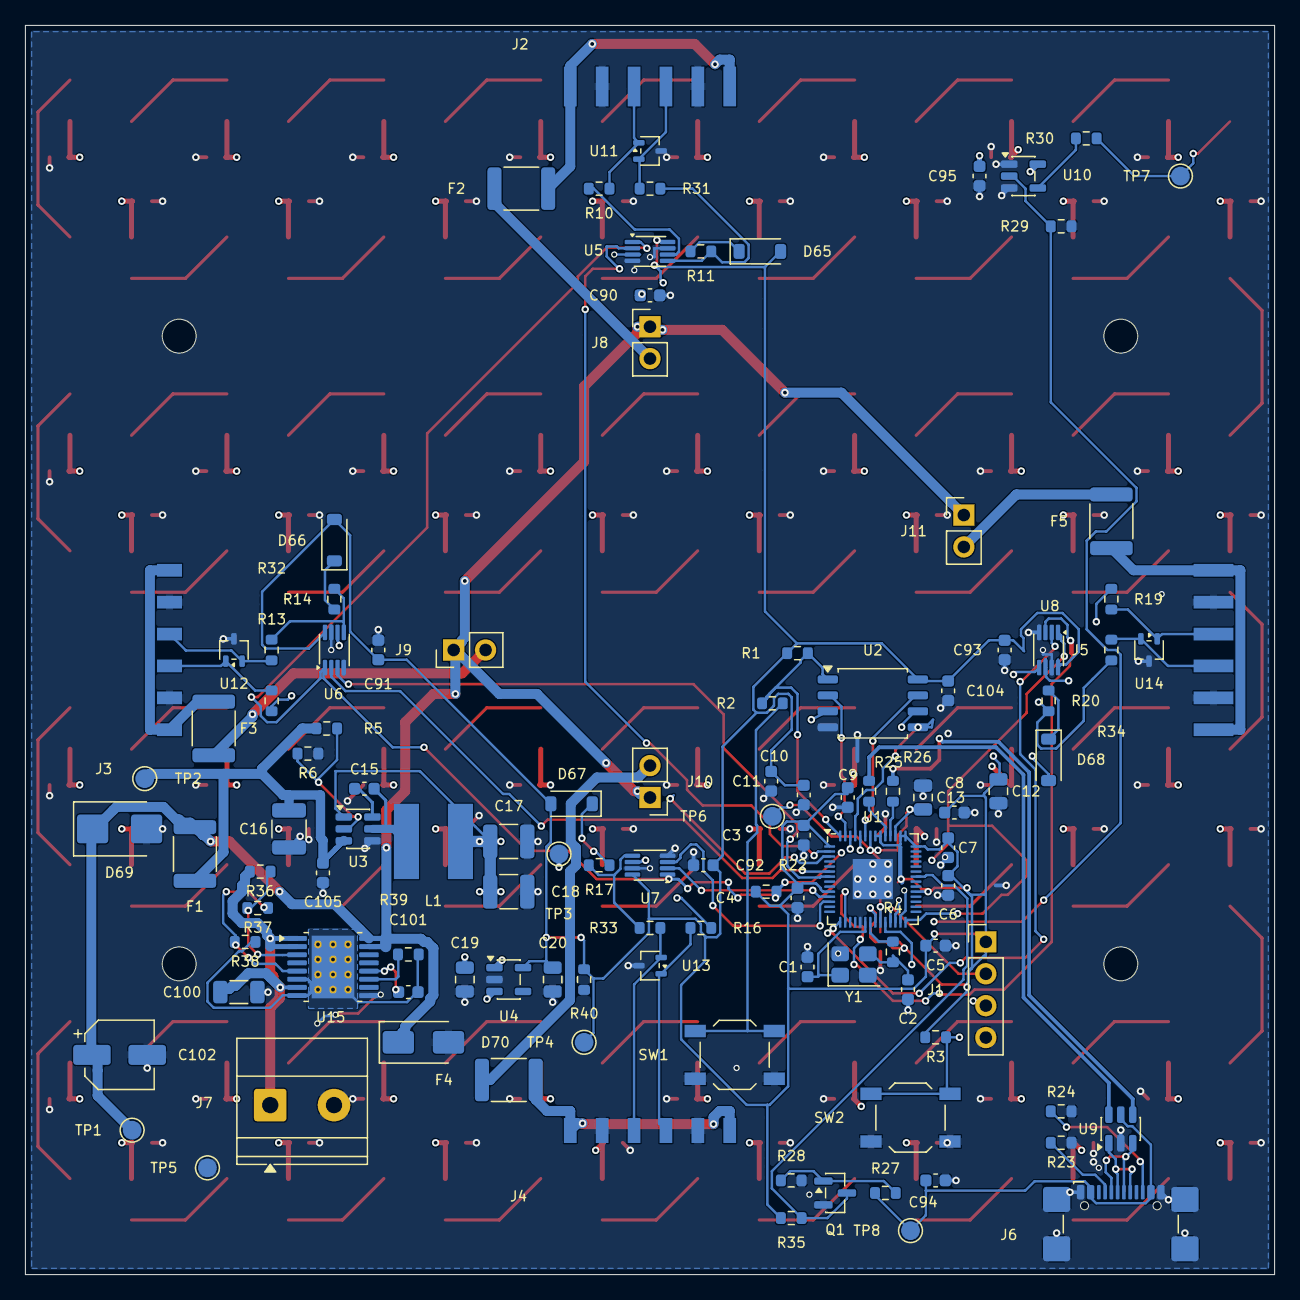
[picture p21: board rgb-tiles.kicad_pcb from below]

Board: 4 copper layers, 99.5 x 99.5 mm, 247 parts (113 on the bottom side), 142 nets.

Other parts of the board:
H1, H2, H3, H4: M2.5; MountingHole_2.7mm_M2.5
