EwoudVV/rgb-tiles/(commit log)

2026-10-25 start rgb tiles
    [rgb-tiles.kicad_pcb, rgb-tiles.kicad_sch]
2026-10-28 draw first rgb tile schematic
    [controller.kicad_sch, interfaces.kicad_sch, leds.kicad_sch, power.kicad_sch, rgb-tiles.kicad_sch, usb-led-data.kicad_sch]
2026-10-29 finish tile schematics and connector footprints
    [controller.kicad_sch, interfaces.kicad_sch, leds.kicad_sch, power-inlet.kicad_sch, power.kicad_sch, rgb-tiles.kicad_sch, usb-led-data.kicad_sch]
2026-10-29 place tile components and route led data chain
    [interfaces.kicad_sch, leds.kicad_sch, power-inlet.kicad_sch, rgb-tiles.kicad_pcb, usb-led-data.kicad_sch]
2026-10-29 finish tile routing and four-layer power layout
    [rgb-tiles.kicad_pcb]
2026-10-29 add firmware, controller and manufacturing files
    [bom.csv, budget.csv, controller.kicad_sch, interfaces.kicad_sch, leds.kicad_sch, power-inlet.kicad_sch, power.kicad_sch, purchase-bom.csv]
2026-10-29 simplify firmware to LED and neighbor-link tests
